Nidhood/PROJECT-CEFIRO/cefiro_gui/THIRD_PARTY_NOTICES.md

The interface architecture and interaction patterns take inspiration from:

- `iKramper/qube-servo-2-in-ros-2/qube_servo2_gui` (2026), original author Elkin Estrada.
- Reference URL: https://github.com/iKramper/qube-servo-2-in-ros-2/tree/main/qube_servo2_gui
- Reference repository MIT license: https://github.com/iKramper/qube-servo-2-in-ros-2/blob/main/LICENSE

CEFIRO implementation consists of new source files customized for the 3-DOF attitude telemetry and controller message contract. Named themes and instrument conventions refer to the original open-source project; this does not establish binary or behavioral equivalence with the original QUBE package.
