Nidhood/PROJECT-CEFIRO/cefiro_description/meshes/frame/prop_ccw.stl

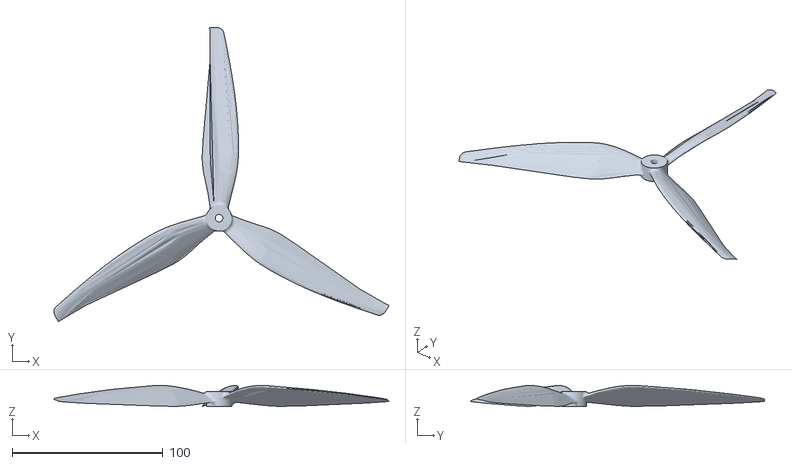
[picture p6: CAD file, 2026-11-02]
cefiro_description/meshes/frame/prop_ccw.stl
222.0 x 195.1 x 14.0
