Nidhood/PROJECT-CEFIRO/cefiro_description/meshes/gyro/narya_ring.stl

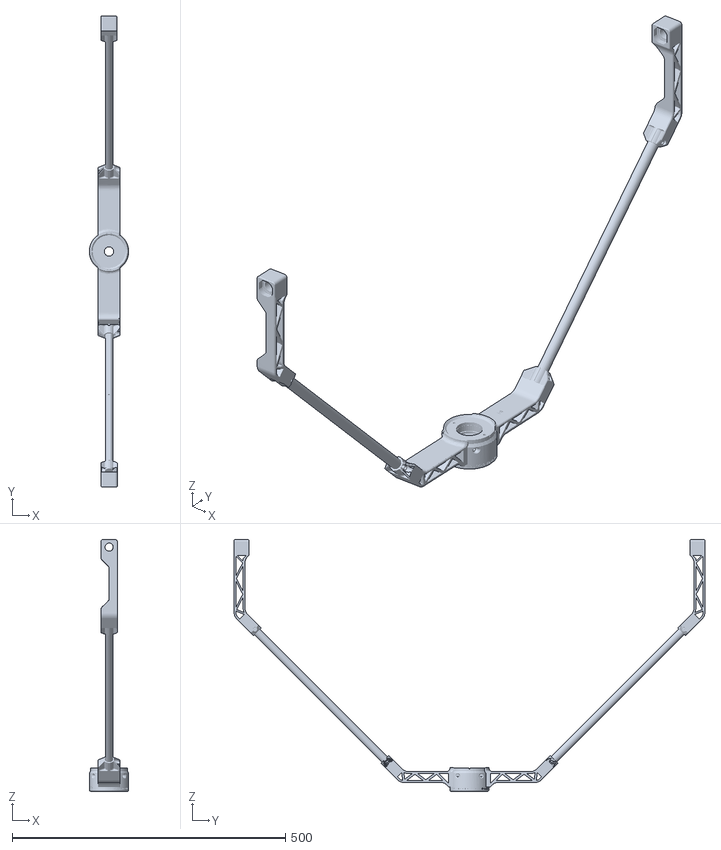
[picture p7: CAD file, 2026-11-02]
cefiro_description/meshes/gyro/narya_ring.stl
72.0 x 861.6 x 461.3
