Nidhood/PROJECT-CEFIRO/cefiro_description/meshes/motor_d3536_1.stl

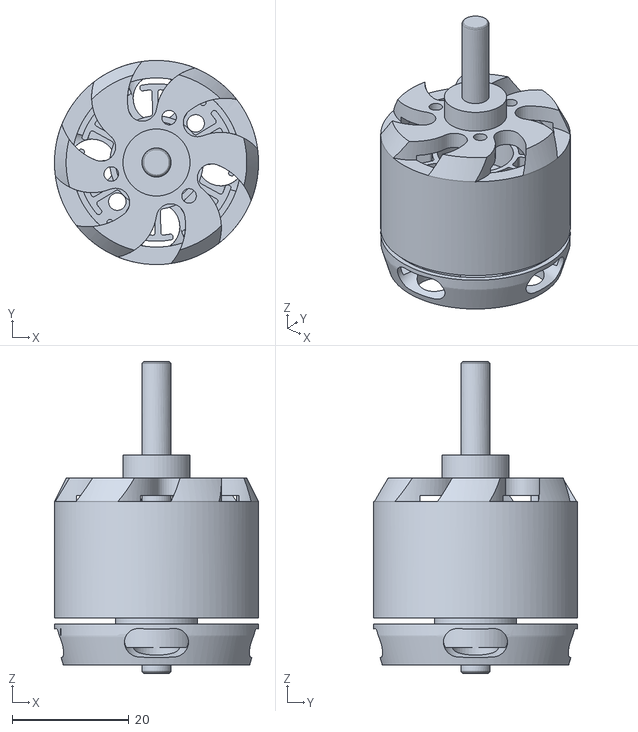
[picture p8: CAD file, 2026-10-26]
cefiro_description/meshes/motor_d3536_1.stl
35.0 x 35.0 x 53.5
