Nidhood/PROJECT-CEFIRO/cefiro_gz/models/desk/meshes/stl/Part__Feature131.stl

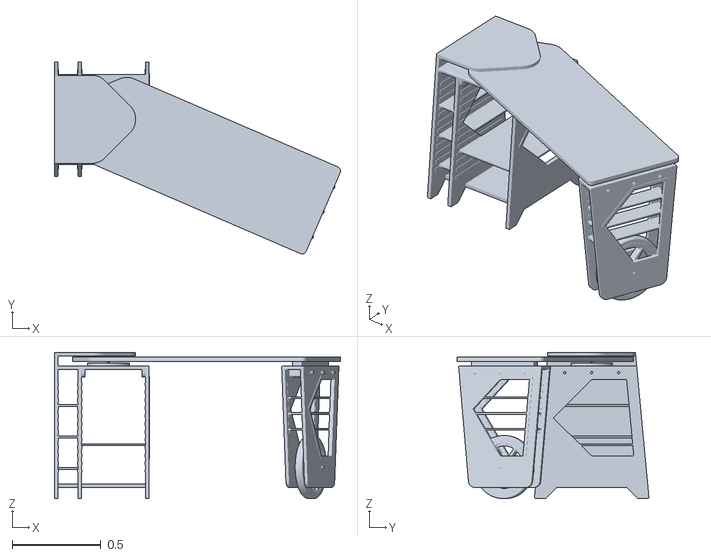
[picture p9: CAD file, 2026-09-05]
cefiro_gz/models/desk/meshes/stl/Part__Feature131.stl
1.62 x 1.08 x 0.825
