Nidhood/PROJECT-CEFIRO/cefiro_gz/models/lamp/meshes/stl/Malla.046.stl

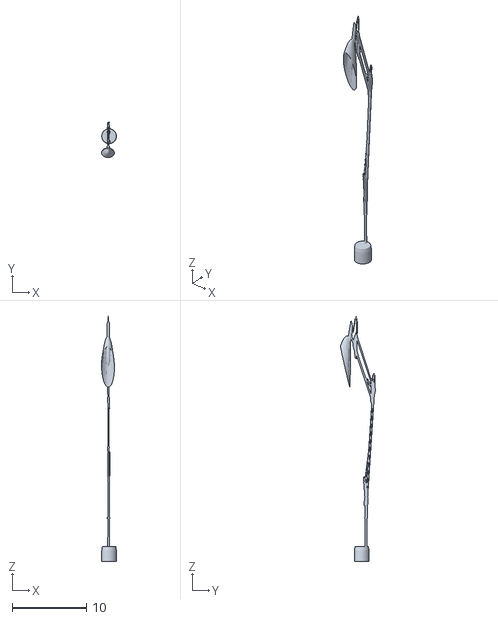
[picture p10: CAD file, 2026-09-05]
cefiro_gz/models/lamp/meshes/stl/Malla.046.stl
2.01 x 4.72 x 33.0
