Nidhood/PROJECT-CEFIRO/cefiro_sensors/urdf/bmp581/meshes/visuals/base_link.stl

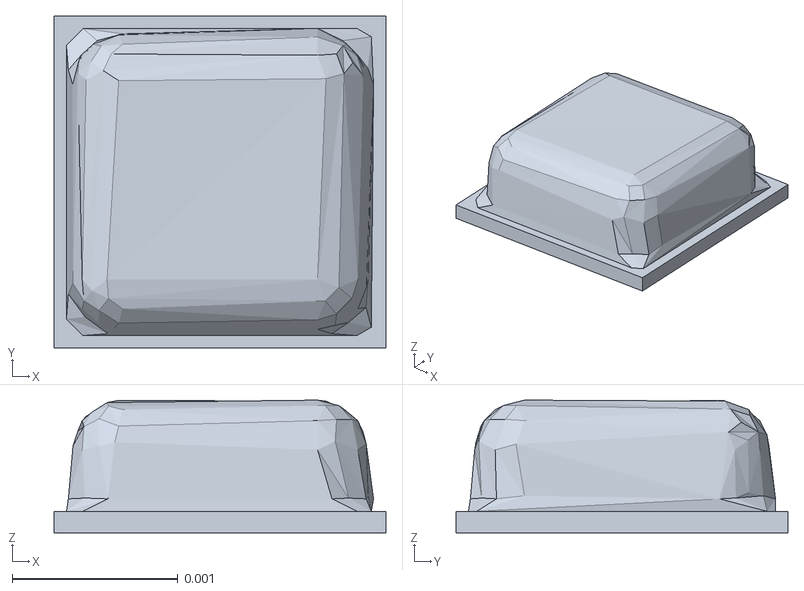
[picture p11: CAD file, 2026-09-05]
cefiro_sensors/urdf/bmp581/meshes/visuals/base_link.stl
0.002 x 0.002 x 0.0008
