Nidhood/PROJECT-CEFIRO/cefiro_sensors/urdf/imu_icm42670p/meshes/base_link.stl

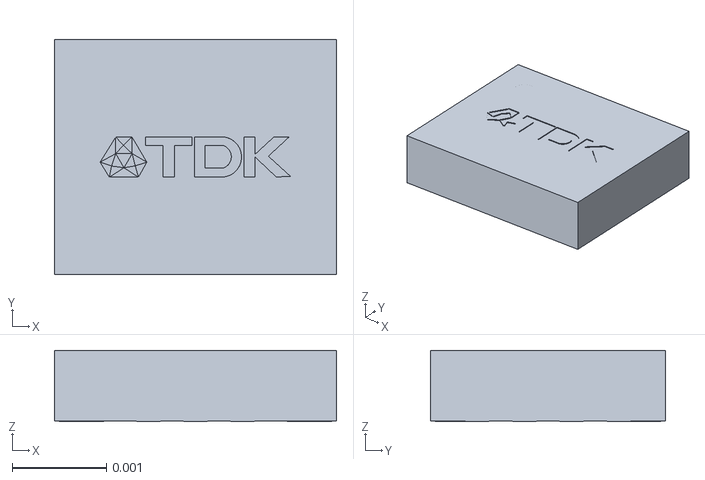
[picture p12: CAD file, 2026-09-12]
cefiro_sensors/urdf/imu_icm42670p/meshes/base_link.stl
0.003 x 0.0025 x 0.00076
