Nidhood/PROJECT-CEFIRO/cefiro_sensors/urdf/magnetometer_mmc5983ma/meshes/base_link.stl

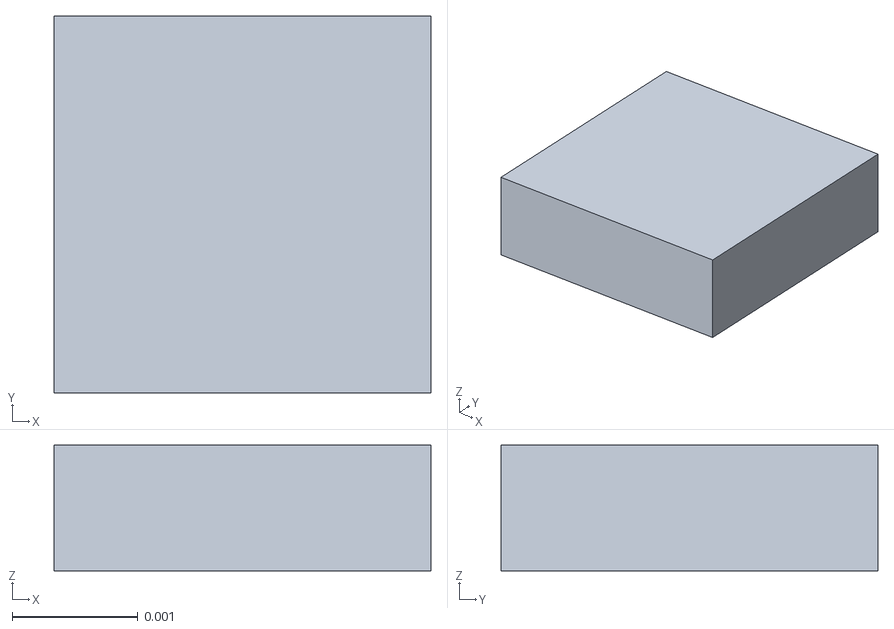
[picture p13: CAD file, 2026-09-12]
cefiro_sensors/urdf/magnetometer_mmc5983ma/meshes/base_link.stl
0.003 x 0.003 x 0.001
