Nidhood/PROJECT-CEFIRO/cefiro_description/meshes/fmu_dummy_1.stl

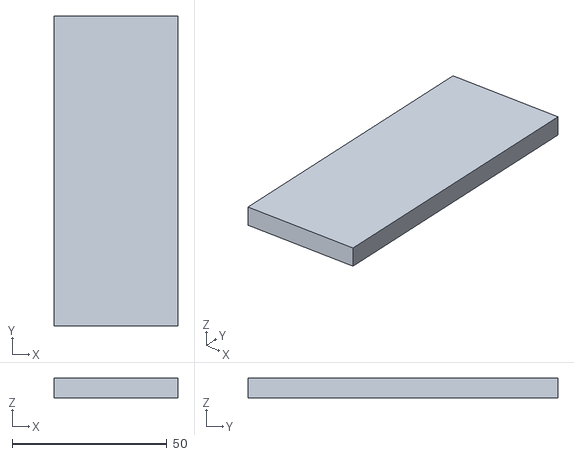
[picture p14: CAD file, 2026-10-26]
cefiro_description/meshes/fmu_dummy_1.stl
40.0 x 100.0 x 6.30
