Nidhood/PROJECT-CEFIRO/cefiro_description/meshes/frame/frame.stl

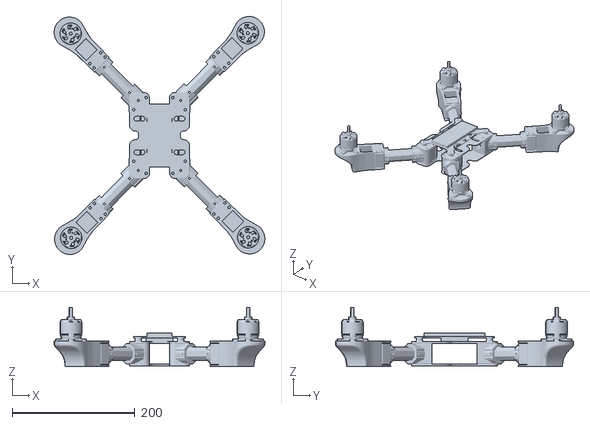
[picture p15: CAD file, 2026-11-02]
cefiro_description/meshes/frame/frame.stl
343.7 x 388.1 x 97.0
