Nidhood/PROJECT-CEFIRO/cefiro_description/meshes/gyro/base.stl

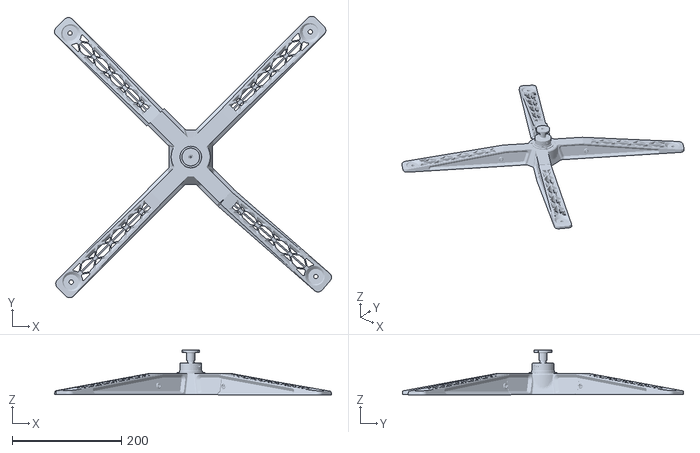
[picture p16: CAD file, 2026-11-02]
cefiro_description/meshes/gyro/base.stl
508.2 x 516.2 x 82.0
