Nidhood/PROJECT-CEFIRO/cefiro_description/meshes/gyro/vilya_ring.stl

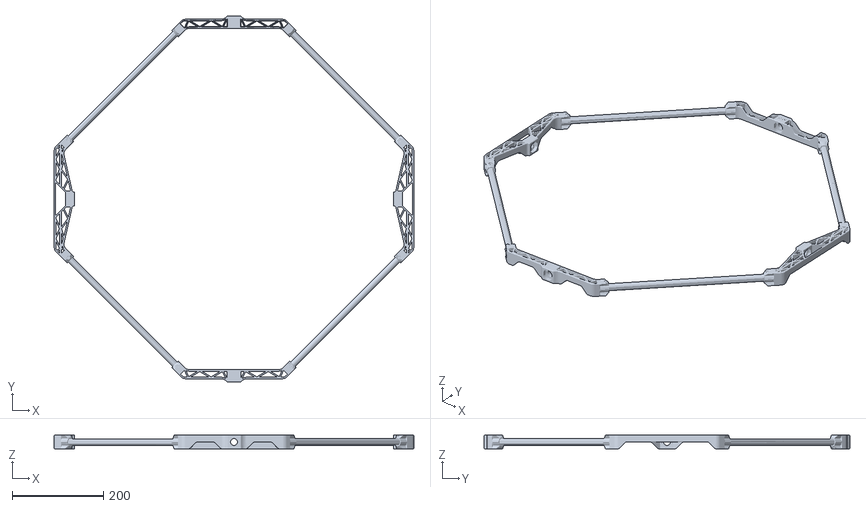
[picture p17: CAD file, 2026-11-02]
cefiro_description/meshes/gyro/vilya_ring.stl
787.8 x 801.8 x 30.0
