Nidhood/PROJECT-CEFIRO/cefiro_description/meshes/propeller_arm__1__1.stl

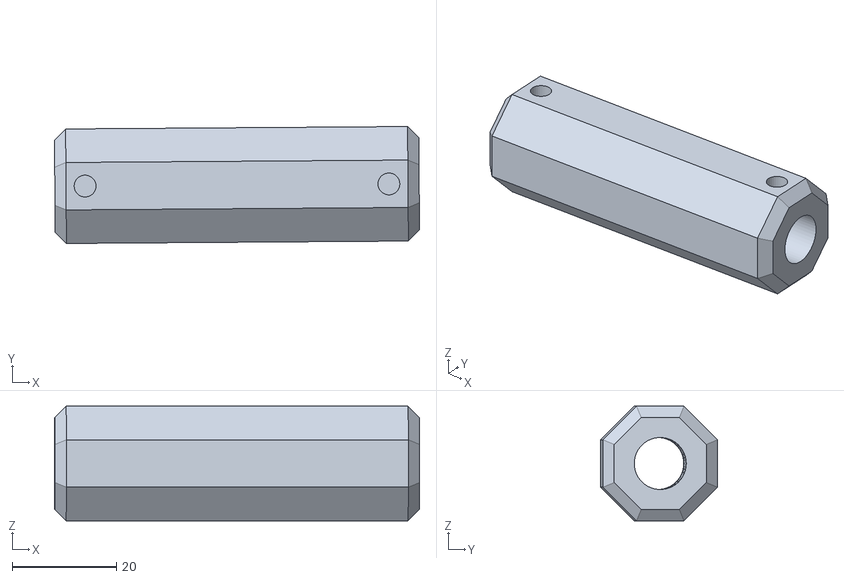
[picture p18: CAD file, 2026-10-26]
cefiro_description/meshes/propeller_arm__1__1.stl
70.1 x 22.5 x 22.0
