Nidhood/PROJECT-CEFIRO/cefiro_description/meshes/frame/motor_coupling__2__1.stl

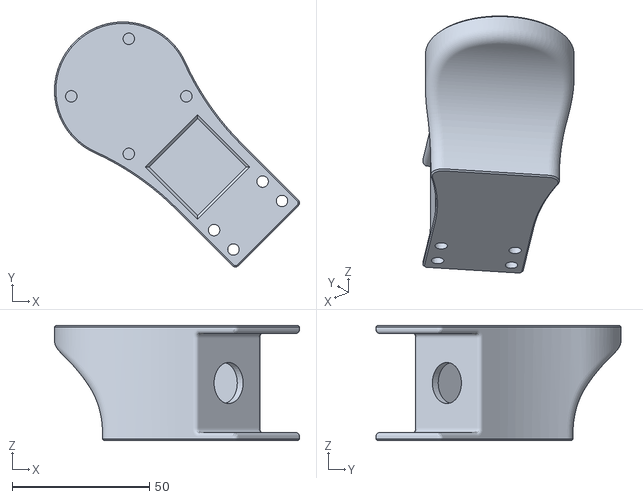
[picture p19: CAD file, 2026-10-28]
cefiro_description/meshes/frame/motor_coupling__2__1.stl
89.4 x 89.4 x 42.0
