Nidhood/PROJECT-CEFIRO/cefiro_description/meshes/gyro/nenya_ring.stl

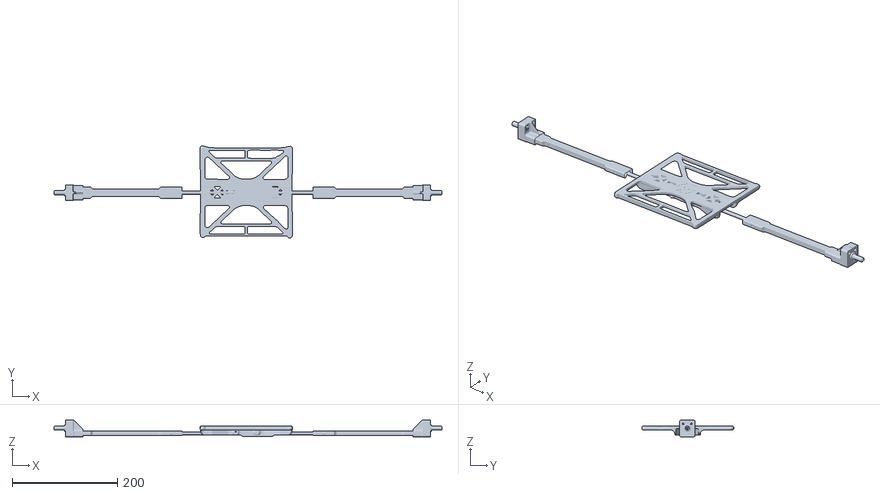
[picture p20: CAD file, 2026-11-02]
cefiro_description/meshes/gyro/nenya_ring.stl
737.8 x 175.4 x 31.5
