Nidhood/PROJECT-CEFIRO/cefiro_description/meshes/gyro_CF_Rod_1.stl

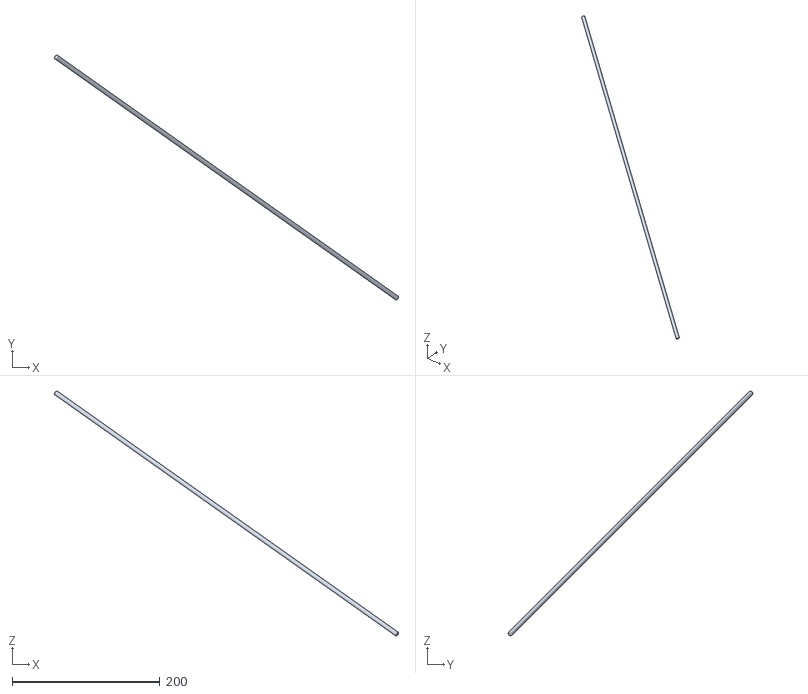
[picture p21: CAD file, 2026-10-26]
cefiro_description/meshes/gyro_CF_Rod_1.stl
465.3 x 331.2 x 331.2
