Nidhood/PROJECT-CEFIRO/cefiro_description/meshes/frame/damper_plate__1.stl

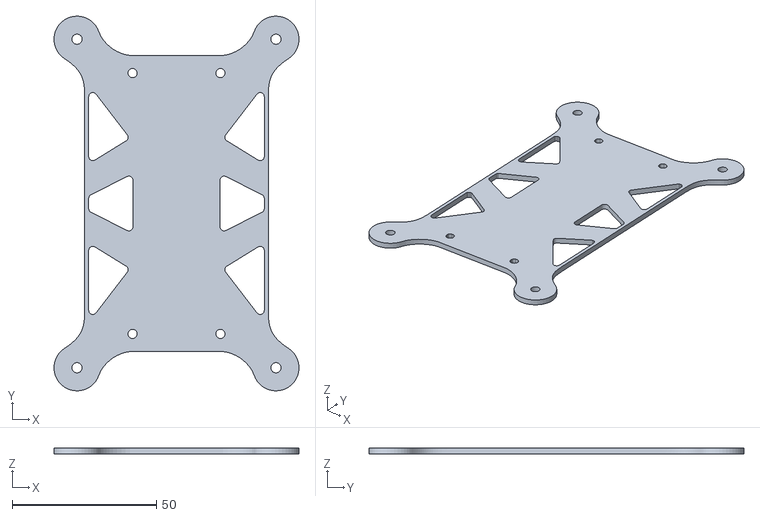
[picture p22: CAD file, 2026-10-28]
cefiro_description/meshes/frame/damper_plate__1.stl
85.0 x 130.0 x 2.10
