Nidhood/PROJECT-CEFIRO/cefiro_description/meshes/gyro/gyro_snap-in-leg__1__1.stl

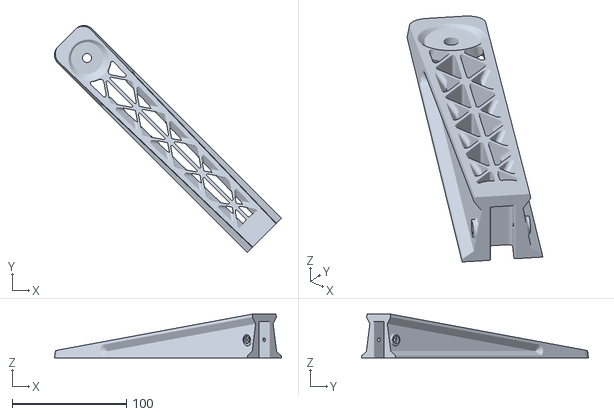
[picture p23: CAD file, 2026-10-28]
cefiro_description/meshes/gyro/gyro_snap-in-leg__1__1.stl
199.0 x 199.0 x 38.5
