Nidhood/PROJECT-CEFIRO/cefiro_description/meshes/gyro_A1-LW_1.stl

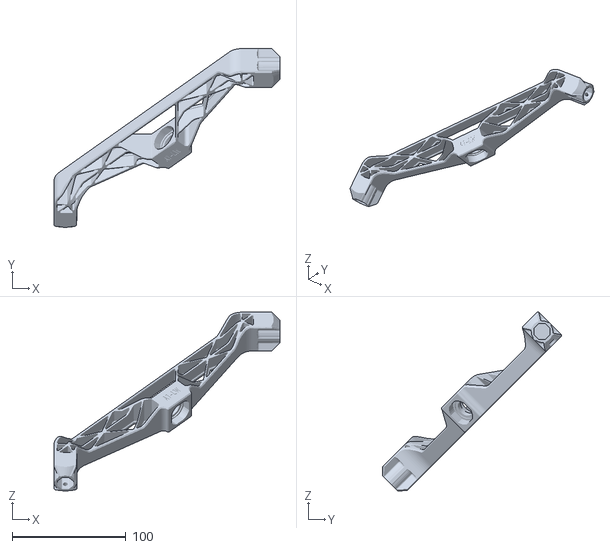
[picture p24: CAD file, 2026-10-26]
cefiro_description/meshes/gyro_A1-LW_1.stl
198.5 x 157.0 x 157.2
