Nidhood/PROJECT-CEFIRO/cefiro_description/meshes/damper_rubber__2__1.stl

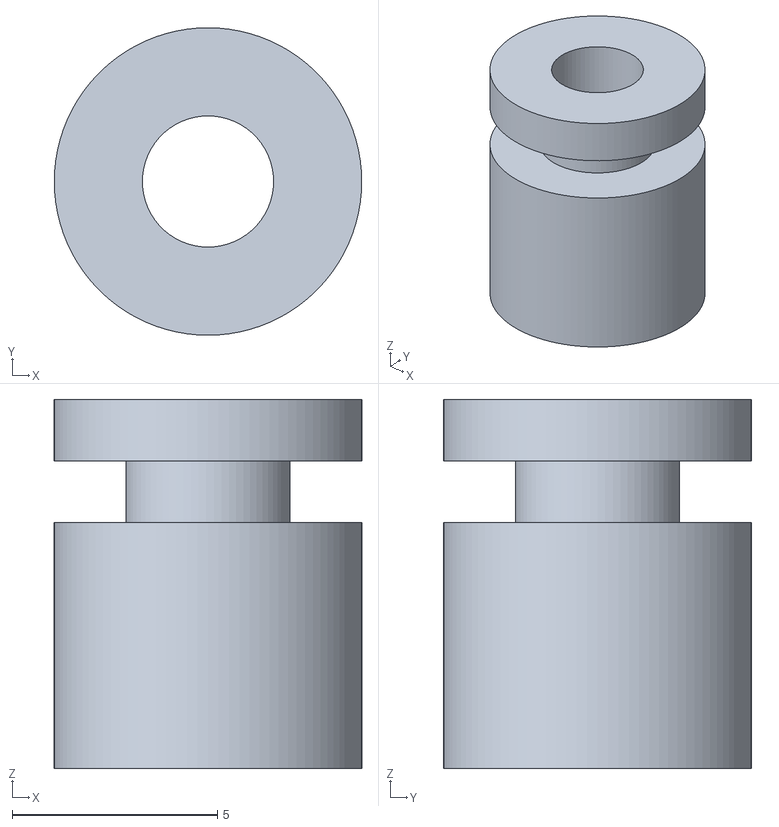
[picture p25: CAD file, 2026-10-26]
cefiro_description/meshes/damper_rubber__2__1.stl
7.50 x 7.50 x 9.00
