Nidhood/PROJECT-CEFIRO/cefiro_description/meshes/gyro/gyro_B2S-R_1.stl

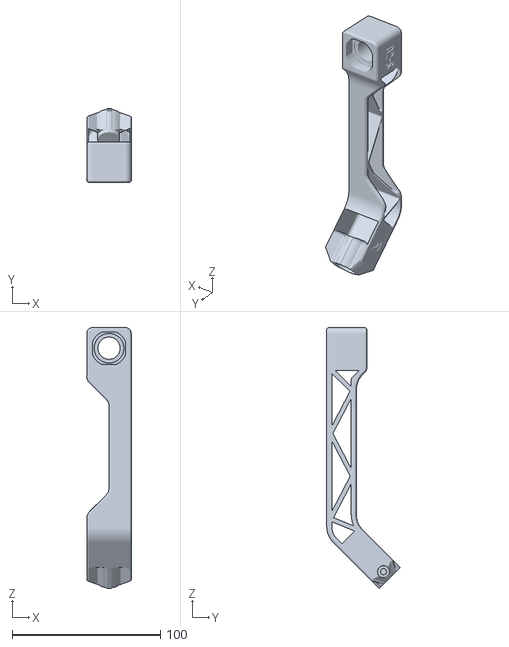
[picture p26: CAD file, 2026-10-28]
cefiro_description/meshes/gyro/gyro_B2S-R_1.stl
30.1 x 49.6 x 175.9
