Nidhood/PROJECT-CEFIRO/cefiro_description/meshes/frame/propeller_arm__2__1.stl

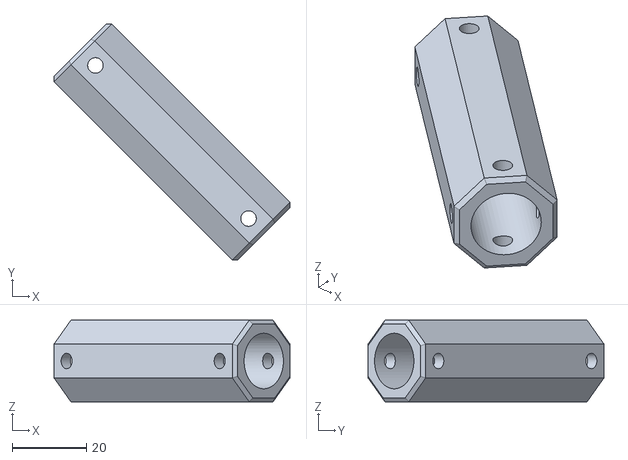
[picture p27: CAD file, 2026-10-28]
cefiro_description/meshes/frame/propeller_arm__2__1.stl
63.6 x 63.6 x 22.0
