Nidhood/PROJECT-CEFIRO/cefiro_description/meshes/gyro_drone_baseB_1.stl

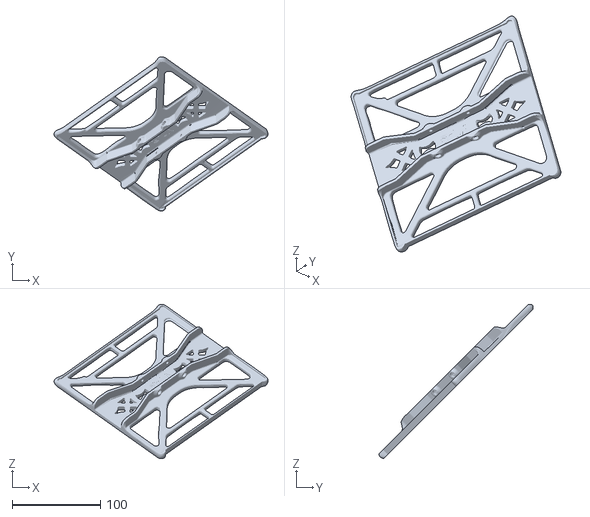
[picture p28: CAD file, 2026-10-26]
cefiro_description/meshes/gyro_drone_baseB_1.stl
243.1 x 175.2 x 175.4
