Nidhood/PROJECT-CEFIRO/cefiro_description/meshes/frame/motor_d3536_mount__2__1.stl

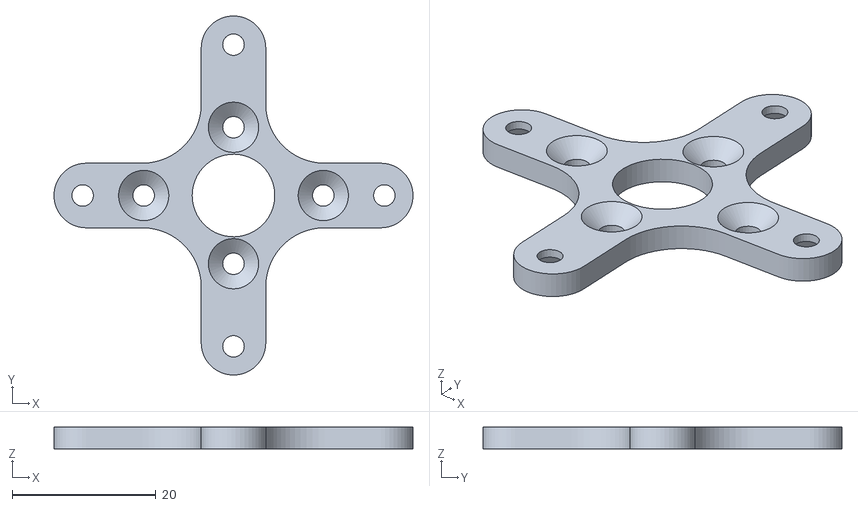
[picture p29: CAD file, 2026-10-28]
cefiro_description/meshes/frame/motor_d3536_mount__2__1.stl
50.0 x 50.0 x 3.00
