Nidhood/PROJECT-CEFIRO/cefiro_description/meshes/gyro/gyro_X1__1__1.stl

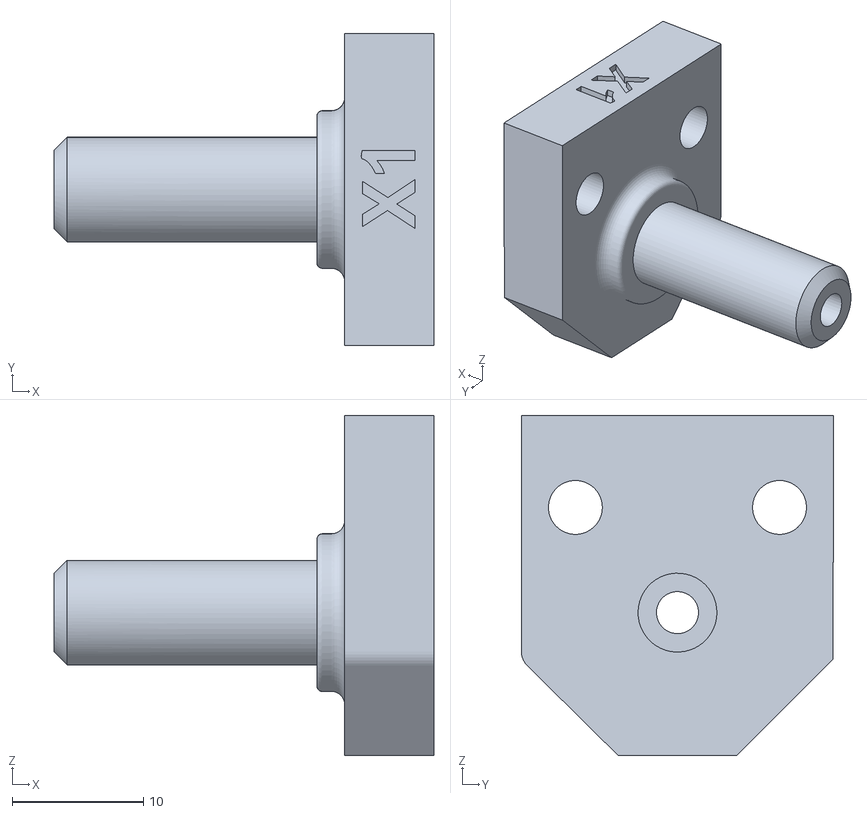
[picture p30: CAD file, 2026-10-28]
cefiro_description/meshes/gyro/gyro_X1__1__1.stl
28.9 x 23.8 x 25.9
