Nidhood/PROJECT-CEFIRO/cefiro_description/meshes/frame/arm_coupling_left__1.stl

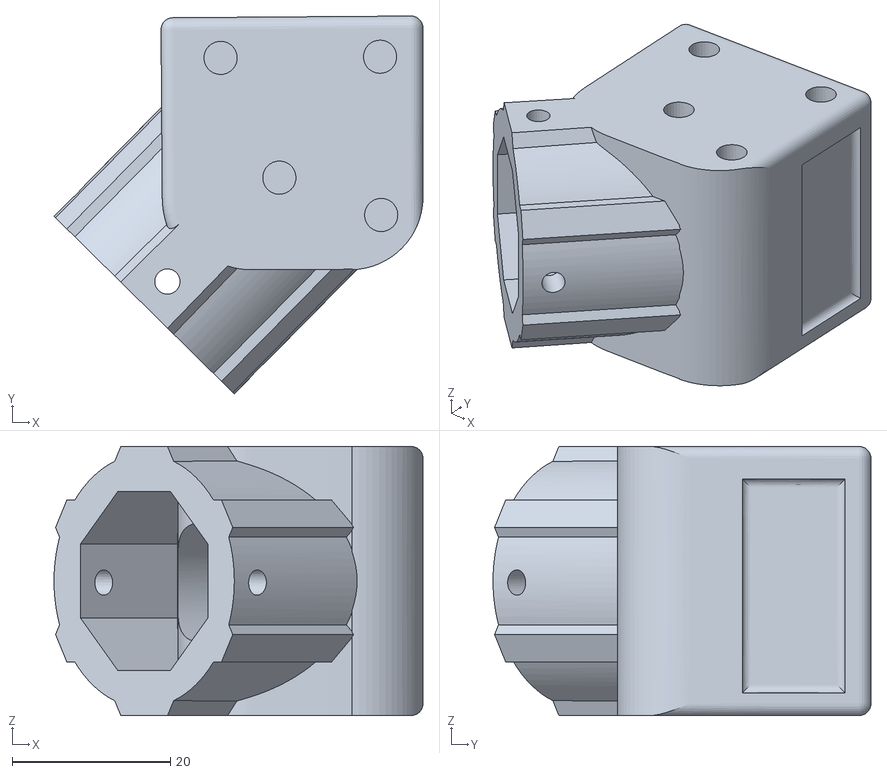
[picture p31: CAD file, 2026-10-28]
cefiro_description/meshes/frame/arm_coupling_left__1.stl
46.6 x 47.8 x 34.0
