Nidhood/PROJECT-CEFIRO/cefiro_description/meshes/gyro/gyro_A2-LW_1.stl

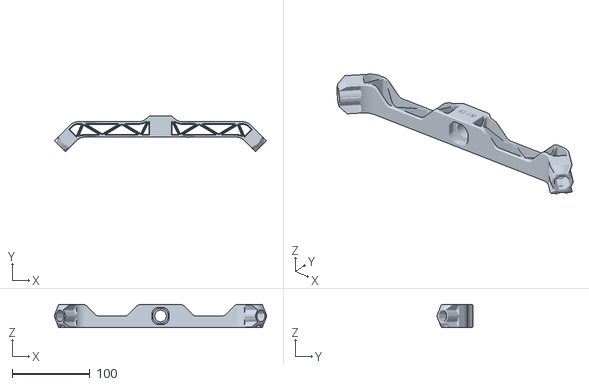
[picture p32: CAD file, 2026-10-28]
cefiro_description/meshes/gyro/gyro_A2-LW_1.stl
273.4 x 46.0 x 30.0
