Nidhood/PROJECT-CEFIRO/cefiro_description/meshes/gyro_A2-LW_1.stl

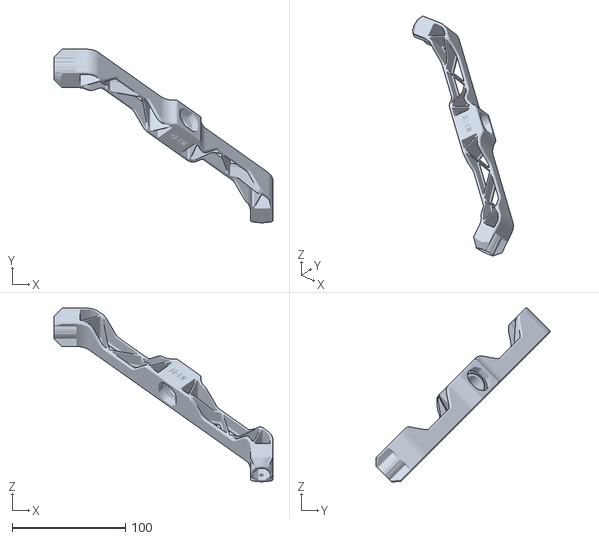
[picture p33: CAD file, 2026-10-26]
cefiro_description/meshes/gyro_A2-LW_1.stl
193.3 x 153.3 x 153.3
