Nidhood/PROJECT-CEFIRO/cefiro_description/meshes/gyro/gyro_CON-P_360mm__2__1.stl

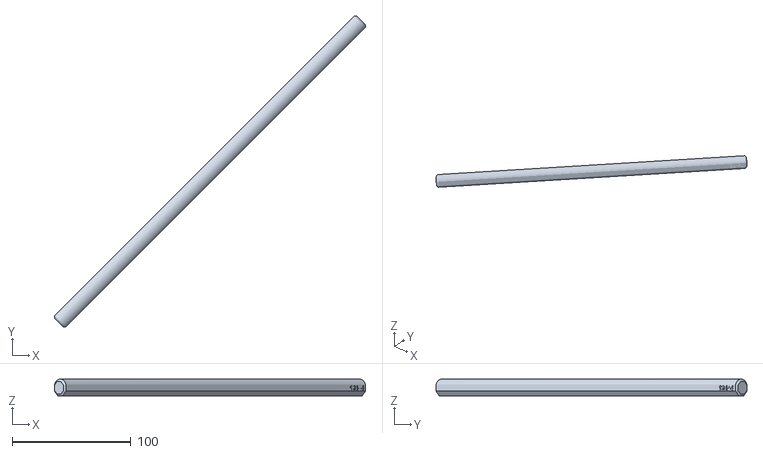
[picture p34: CAD file, 2026-10-28]
cefiro_description/meshes/gyro/gyro_CON-P_360mm__2__1.stl
262.2 x 262.2 x 14.2
