Nidhood/PROJECT-CEFIRO/cefiro_description/meshes/arm-motor_coupling__2__1.stl

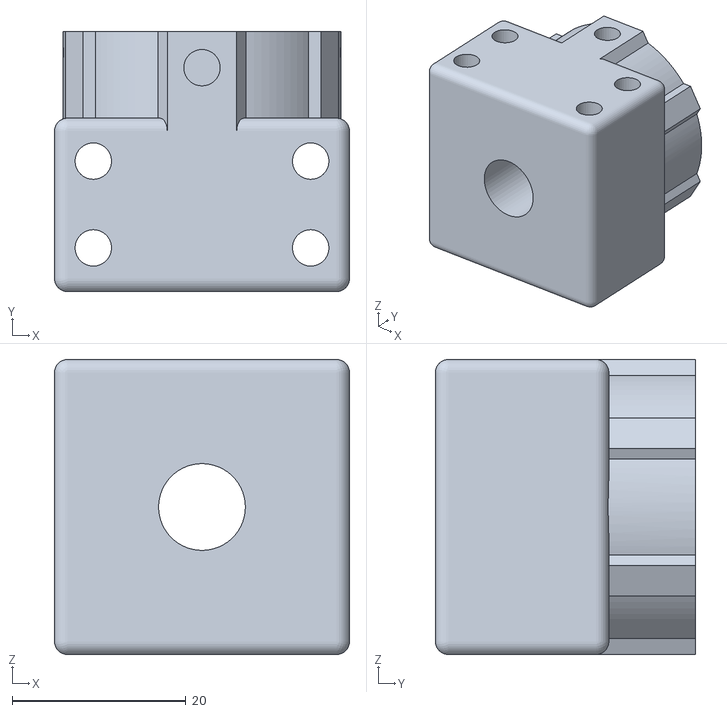
[picture p35: CAD file, 2026-10-26]
cefiro_description/meshes/arm-motor_coupling__2__1.stl
34.0 x 30.0 x 34.0
