Nidhood/PROJECT-CEFIRO/cefiro_description/meshes/gyro/gyro_R-BED__1__1.stl

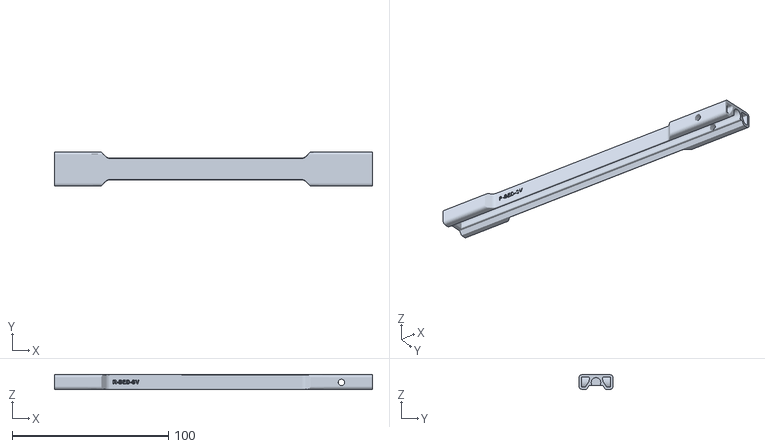
[picture p36: CAD file, 2026-10-28]
cefiro_description/meshes/gyro/gyro_R-BED__1__1.stl
203.6 x 21.9 x 9.40
