Nidhood/PROJECT-CEFIRO/cefiro_description/meshes/base_link.stl

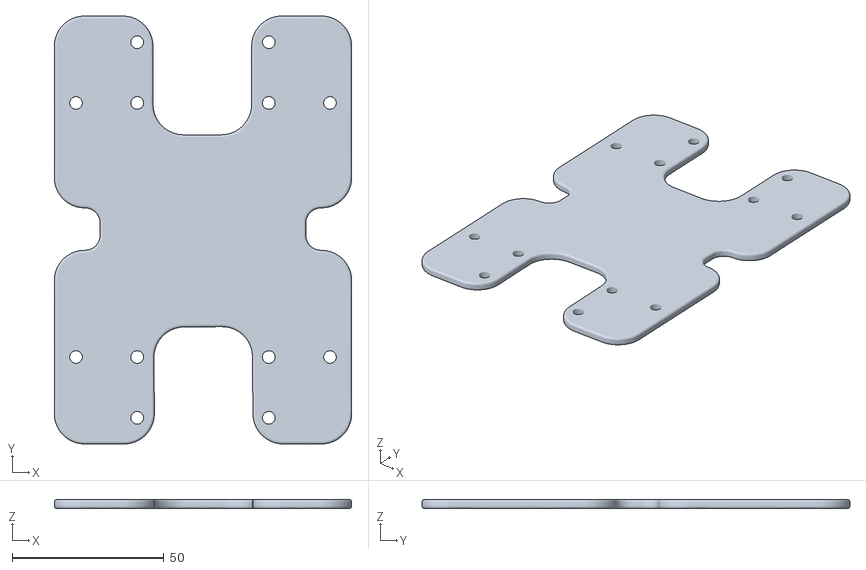
[picture p37: CAD file, 2026-10-26]
cefiro_description/meshes/base_link.stl
98.0 x 141.0 x 3.00
