Nidhood/PROJECT-CEFIRO/cefiro_description/meshes/gyro/gyro_CON-Y_368mm__1__1.stl

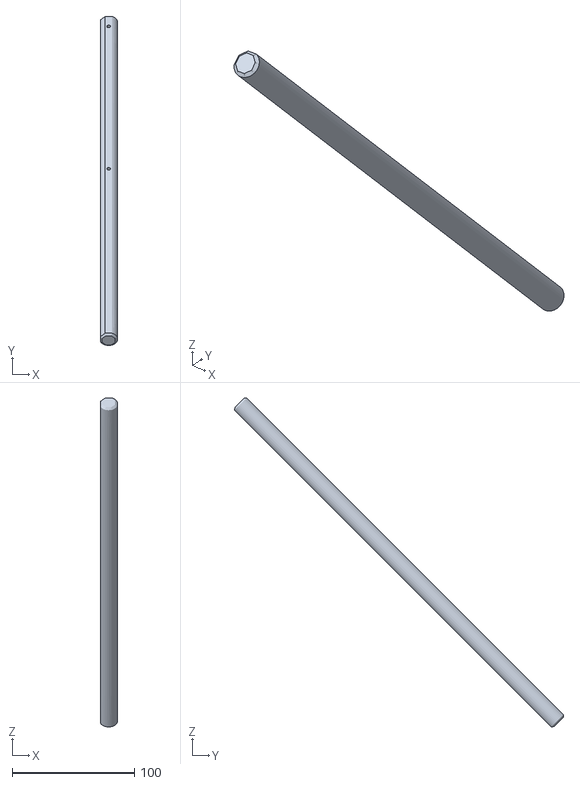
[picture p38: CAD file, 2026-10-28]
cefiro_description/meshes/gyro/gyro_CON-Y_368mm__1__1.stl
14.2 x 269.6 x 269.6
