Nidhood/PROJECT-CEFIRO/cefiro_description/meshes/arm_coupling_1.stl

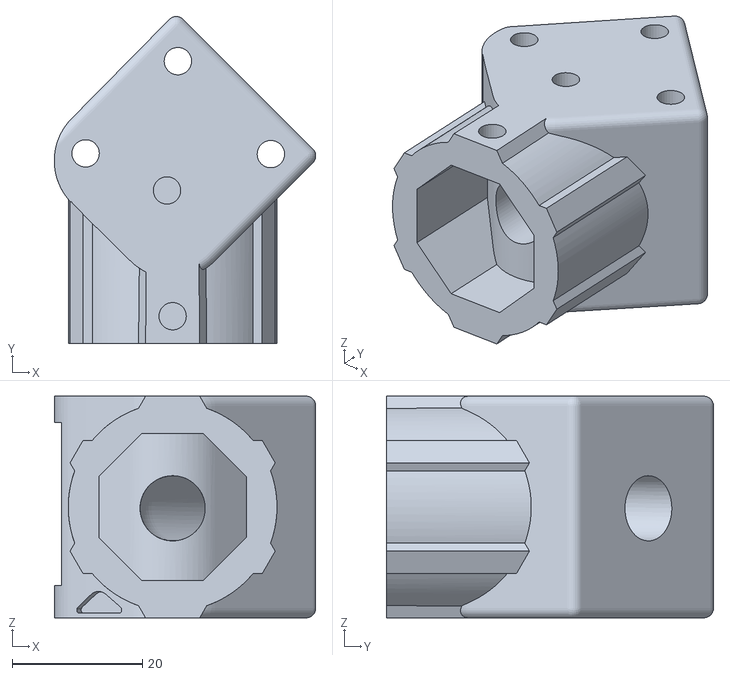
[picture p39: CAD file, 2026-10-26]
cefiro_description/meshes/arm_coupling_1.stl
40.1 x 50.1 x 34.0
