Nidhood/PROJECT-CEFIRO/cefiro_description/meshes/gyro/gyro_base_CPv12_1.stl

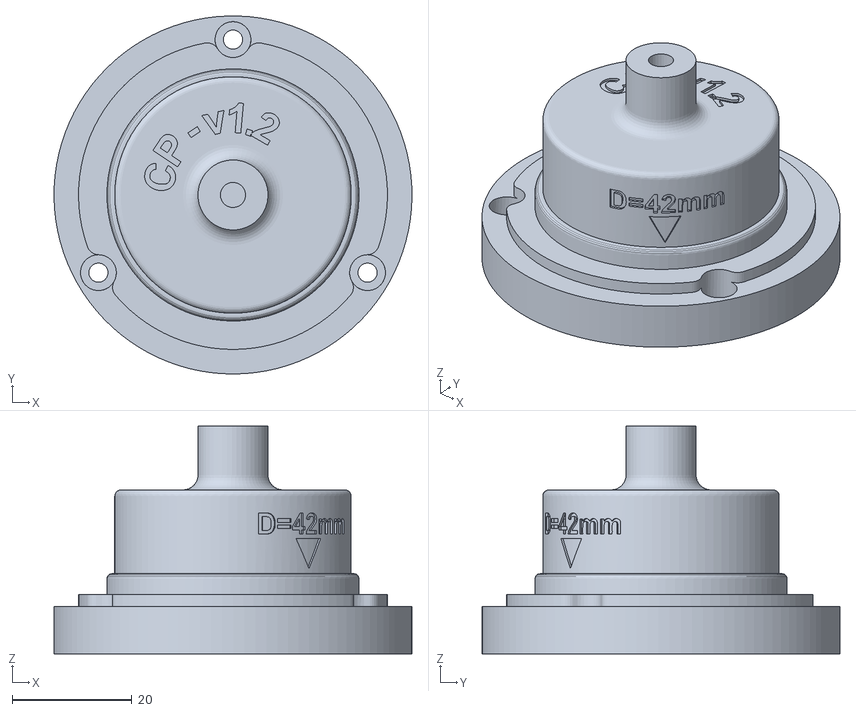
[picture p40: CAD file, 2026-10-28]
cefiro_description/meshes/gyro/gyro_base_CPv12_1.stl
59.8 x 59.8 x 38.1
