Nidhood/PROJECT-CEFIRO/cefiro_description/meshes/frame/chassis_upper_plate_1.stl

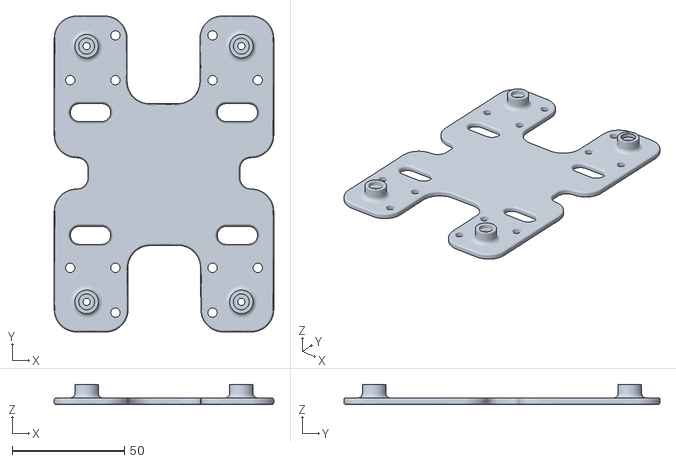
[picture p41: CAD file, 2026-10-28]
cefiro_description/meshes/frame/chassis_upper_plate_1.stl
98.0 x 141.0 x 9.00
