Nidhood/PROJECT-CEFIRO/cefiro_description/meshes/gyro/gyro_X1-SV_1.stl

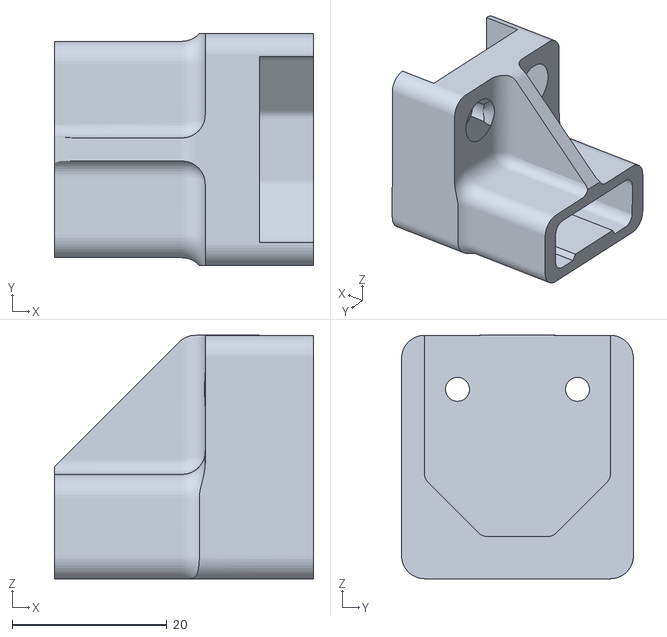
[picture p42: CAD file, 2026-10-28]
cefiro_description/meshes/gyro/gyro_X1-SV_1.stl
33.5 x 30.0 x 31.5
