Nidhood/PROJECT-CEFIRO/cefiro_description/meshes/frame/motor_coupling__1__1.stl

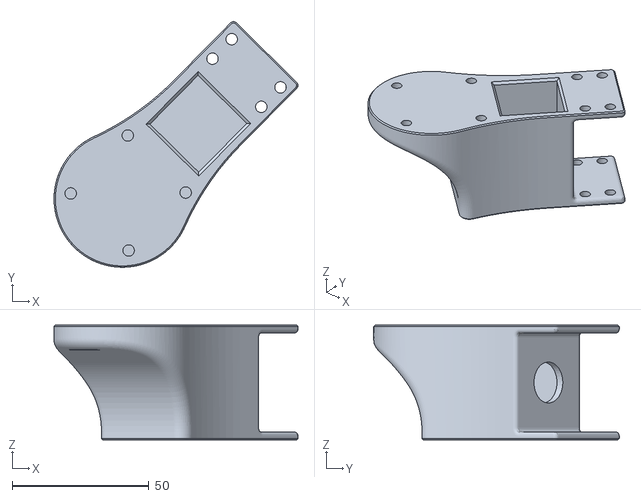
[picture p43: CAD file, 2026-10-28]
cefiro_description/meshes/frame/motor_coupling__1__1.stl
89.1 x 89.7 x 42.0
