Nidhood/PROJECT-CEFIRO/cefiro_description/meshes/frame/arm-motor_coupling__2__1.stl

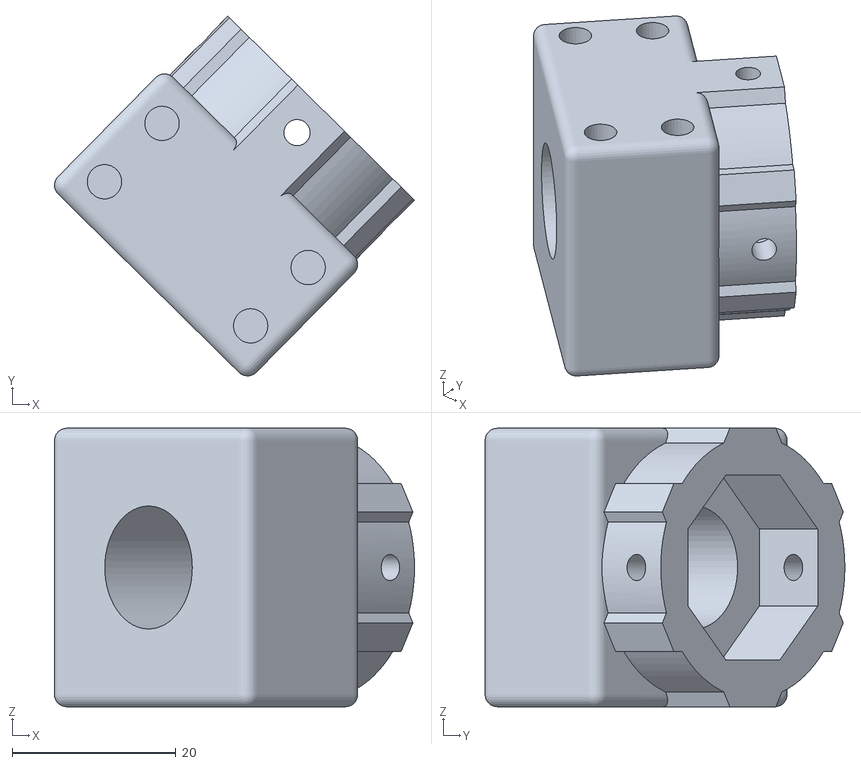
[picture p44: CAD file, 2026-10-28]
cefiro_description/meshes/frame/arm-motor_coupling__2__1.stl
43.9 x 43.9 x 34.0
