Nidhood/PROJECT-CEFIRO/cefiro_description/meshes/gyro/base_link.stl

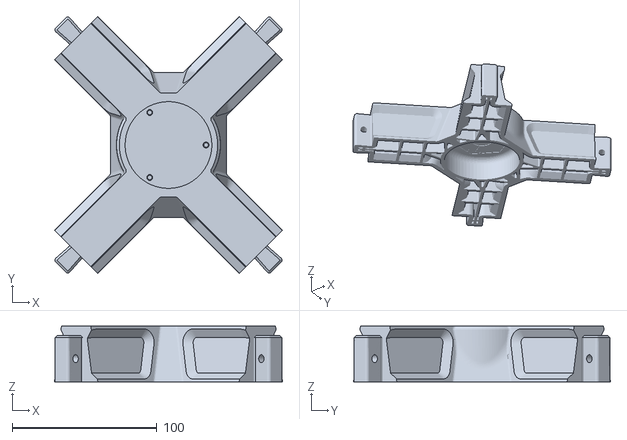
[picture p45: CAD file, 2026-10-28]
cefiro_description/meshes/gyro/base_link.stl
157.8 x 177.8 x 38.5
