Nidhood/PROJECT-CEFIRO/cefiro_description/meshes/gyro_R-BED__1__1.stl

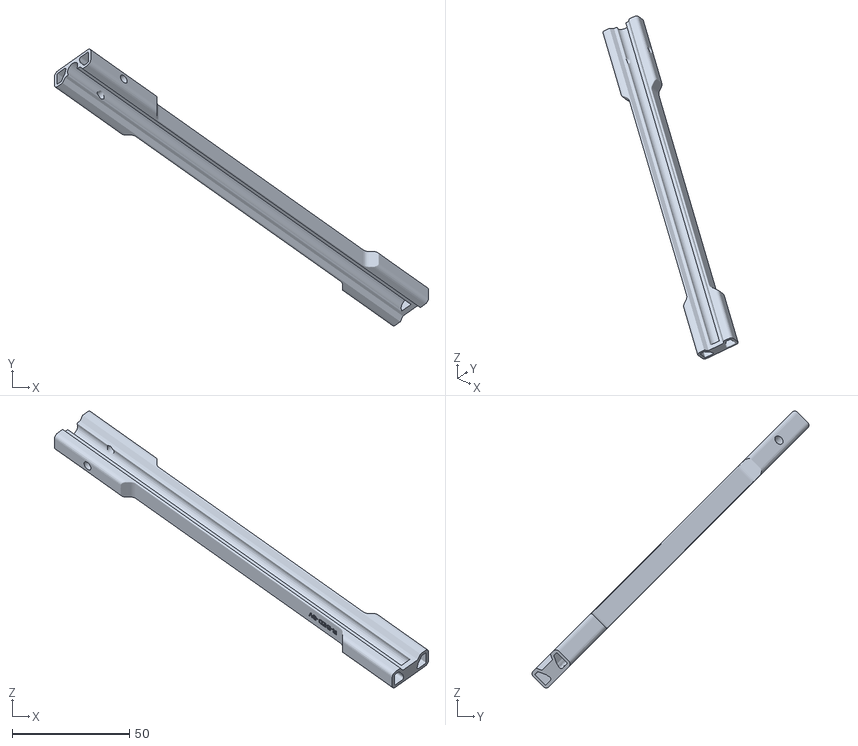
[picture p46: CAD file, 2026-10-26]
cefiro_description/meshes/gyro_R-BED__1__1.stl
159.4 x 118.0 x 118.0
