Nidhood/PROJECT-CEFIRO/cefiro_description/meshes/gyro/gyro_drone_baseB_1.stl

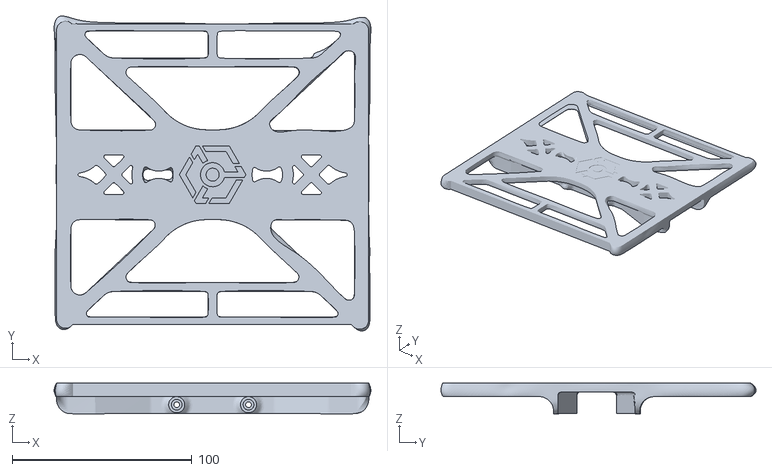
[picture p47: CAD file, 2026-10-28]
cefiro_description/meshes/gyro/gyro_drone_baseB_1.stl
176.4 x 175.4 x 17.1
