Nidhood/PROJECT-CEFIRO/cefiro_description/meshes/gyro_B2S-R_1.stl

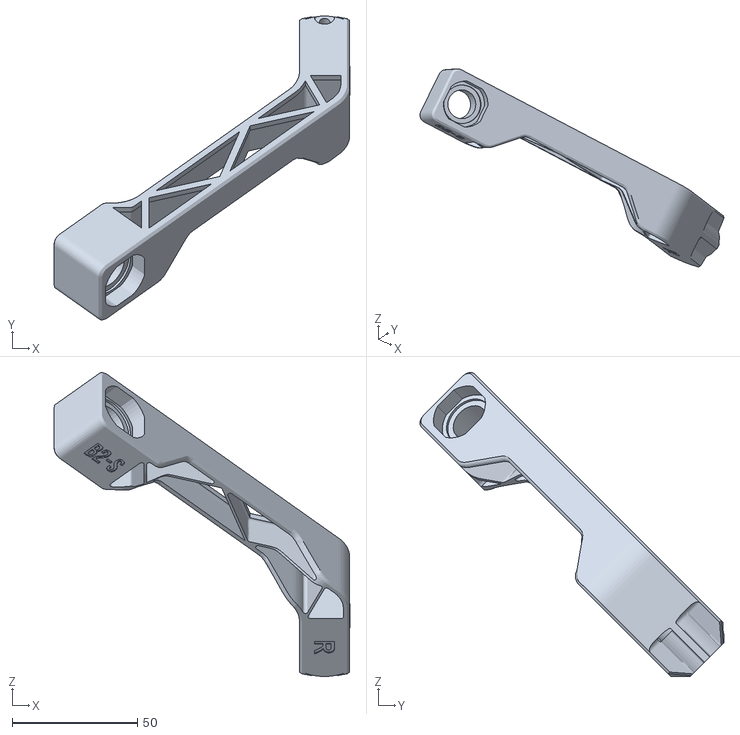
[picture p48: CAD file, 2026-10-26]
cefiro_description/meshes/gyro_B2S-R_1.stl
117.8 x 121.1 x 121.1
