Nidhood/PROJECT-CEFIRO/cefiro_description/meshes/frame/propeller__3__1.stl

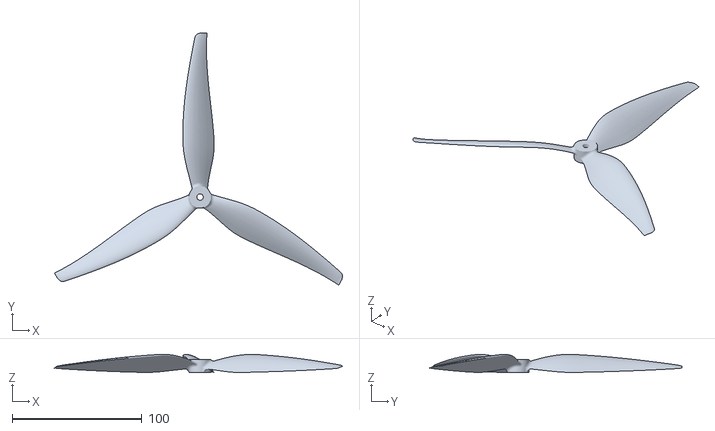
[picture p49: CAD file, 2026-10-28]
cefiro_description/meshes/frame/propeller__3__1.stl
222.0 x 194.4 x 14.0
