Nidhood/PROJECT-CEFIRO/cefiro_description/meshes/gyro/gyro_A1-LW__1__1.stl

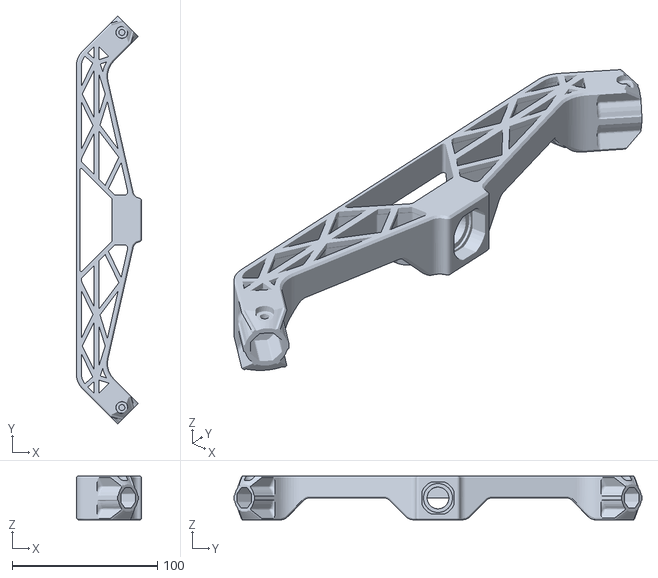
[picture p50: CAD file, 2026-10-28]
cefiro_description/meshes/gyro/gyro_A1-LW__1__1.stl
45.0 x 280.7 x 30.0
