Nidhood/PROJECT-CEFIRO/cefiro_description/meshes/gyro/gyro_Y-DBA_1.stl

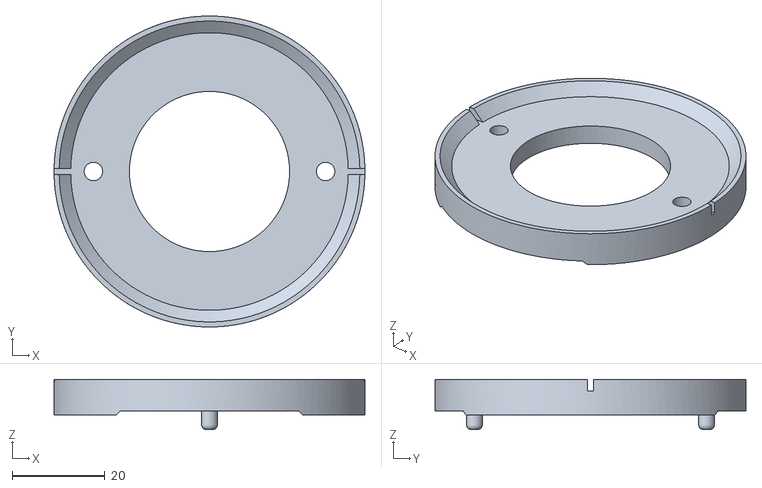
[picture p51: CAD file, 2026-10-28]
cefiro_description/meshes/gyro/gyro_Y-DBA_1.stl
67.0 x 67.0 x 10.8
