Nidhood/PROJECT-CEFIRO/cefiro_description/meshes/gyro/gyro_Y-LOCK_1.stl

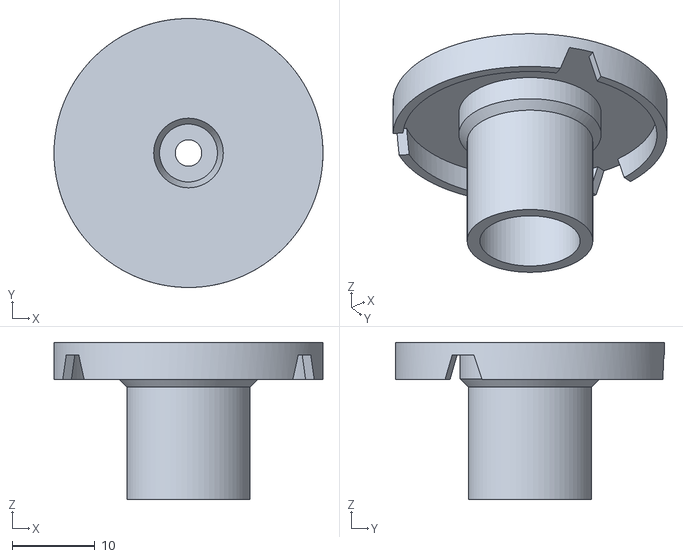
[picture p52: CAD file, 2026-10-28]
cefiro_description/meshes/gyro/gyro_Y-LOCK_1.stl
32.5 x 32.5 x 19.0
