Nidhood/PROJECT-CEFIRO/cefiro_description/meshes/gyro/gyro_B1P_1.stl

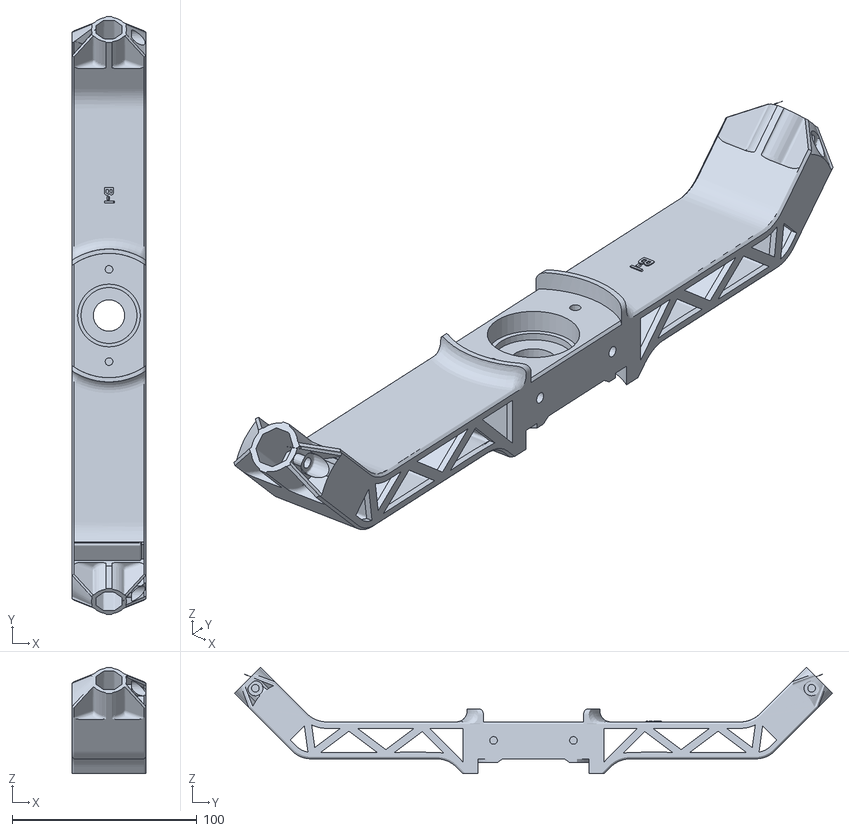
[picture p53: CAD file, 2026-10-28]
cefiro_description/meshes/gyro/gyro_B1P_1.stl
40.0 x 323.9 x 57.6
