Nidhood/PROJECT-CEFIRO/cefiro_description/meshes/gyro/gyro_CF_Rod_1.stl

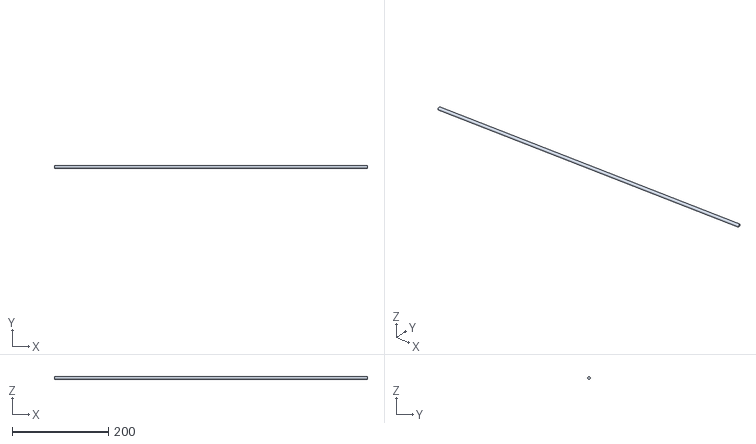
[picture p54: CAD file, 2026-10-28]
cefiro_description/meshes/gyro/gyro_CF_Rod_1.stl
652.0 x 6.00 x 6.00
