Nidhood/PROJECT-CEFIRO/cefiro_description/meshes/gyro_X1-SV_1.stl

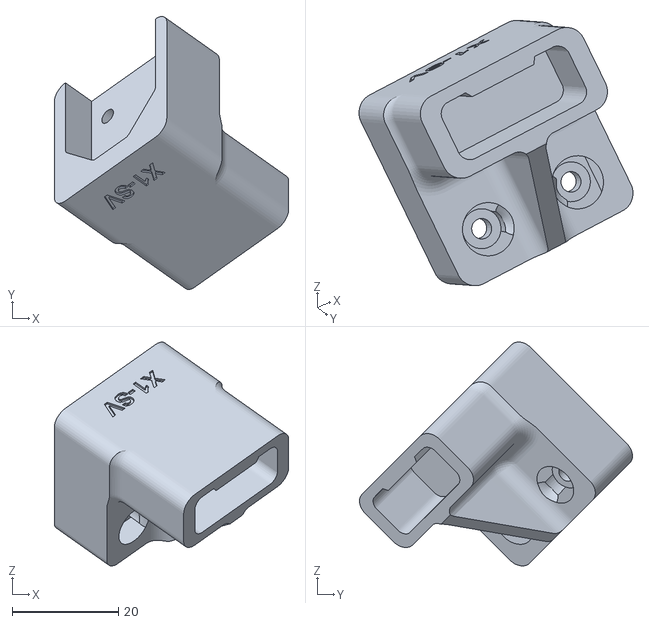
[picture p55: CAD file, 2026-10-26]
cefiro_description/meshes/gyro_X1-SV_1.stl
44.2 x 51.5 x 42.2
