Nidhood/PROJECT-CEFIRO/cefiro_description/meshes/frame/propeller_arm__1__1.stl

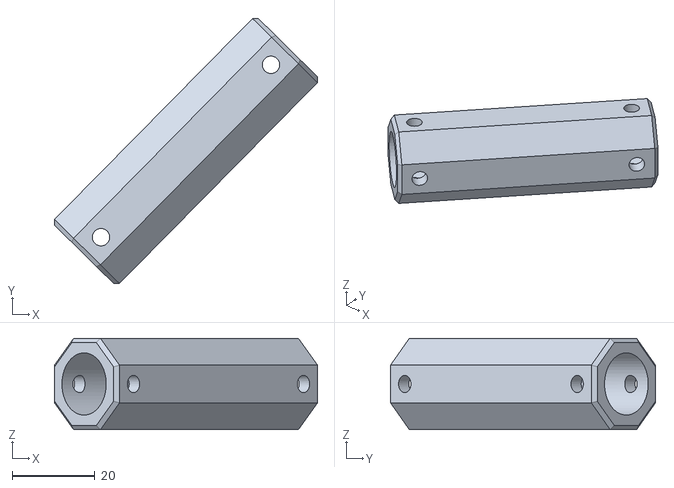
[picture p56: CAD file, 2026-10-28]
cefiro_description/meshes/frame/propeller_arm__1__1.stl
63.4 x 63.9 x 22.0
