Nidhood/PROJECT-CEFIRO/cefiro_description/meshes/gyro/gyro_snap-in-leg__3__1.stl

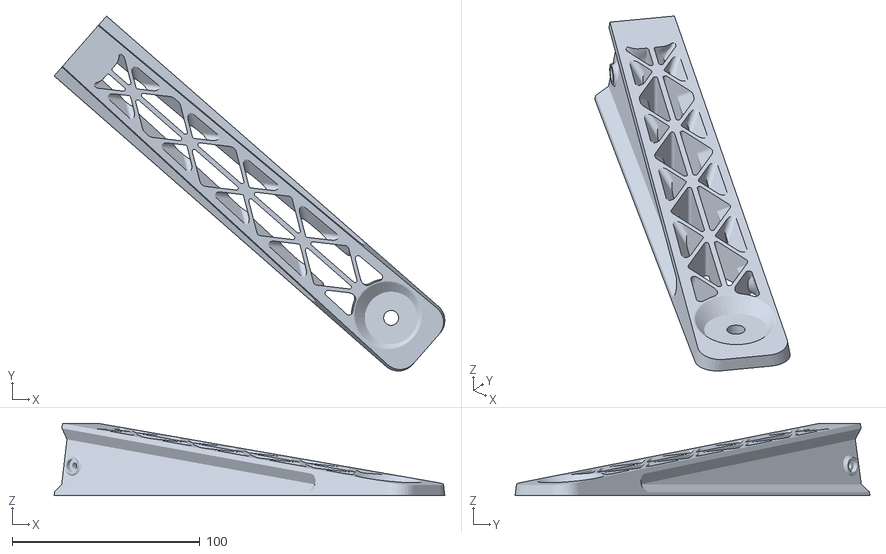
[picture p57: CAD file, 2026-10-28]
cefiro_description/meshes/gyro/gyro_snap-in-leg__3__1.stl
208.1 x 189.1 x 38.5
