Nidhood/PROJECT-CEFIRO/cefiro_description/meshes/gyro/gyro_CON-BED-ADAPTER_6mm_1.stl

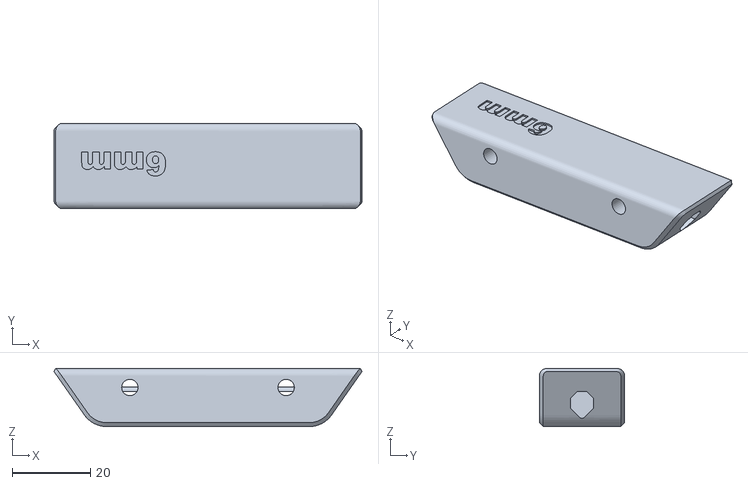
[picture p58: CAD file, 2026-10-28]
cefiro_description/meshes/gyro/gyro_CON-BED-ADAPTER_6mm_1.stl
78.9 x 21.9 x 14.9
