Nidhood/PROJECT-CEFIRO/cefiro_description/meshes/motor_coupling__2__1.stl

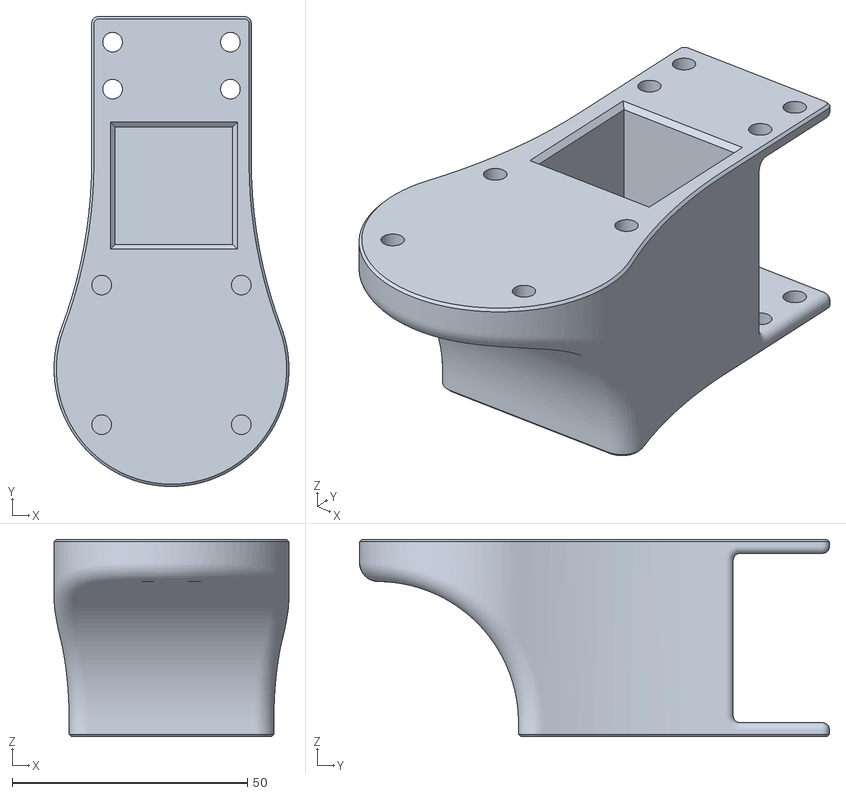
[picture p59: CAD file, 2026-10-26]
cefiro_description/meshes/motor_coupling__2__1.stl
50.0 x 100.0 x 42.0
