Nidhood/PROJECT-CEFIRO/cefiro_description/meshes/frame/esc_dummy_1.stl

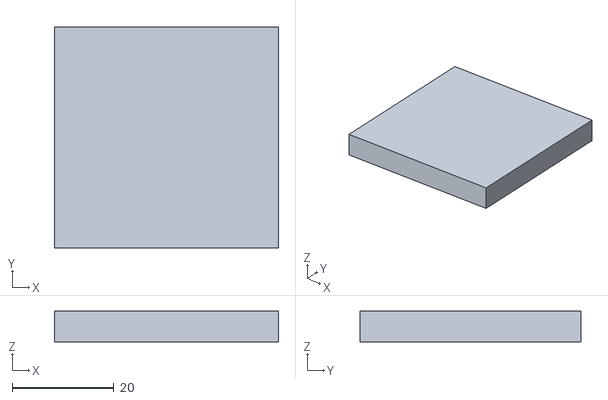
[picture p60: CAD file, 2026-10-28]
cefiro_description/meshes/frame/esc_dummy_1.stl
44.0 x 43.5 x 6.00
