Nidhood/PROJECT-CEFIRO/cefiro_description/meshes/chassis_upper_plate_1.stl

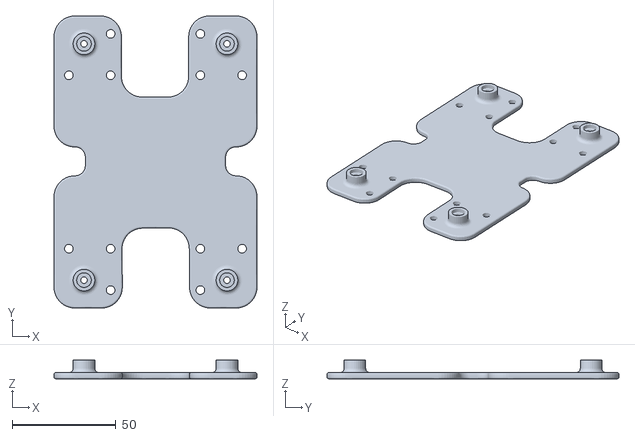
[picture p61: CAD file, 2026-10-26]
cefiro_description/meshes/chassis_upper_plate_1.stl
98.0 x 141.0 x 9.00
