Nidhood/PROJECT-CEFIRO/cefiro_description/meshes/gyro_ccv12_1.stl

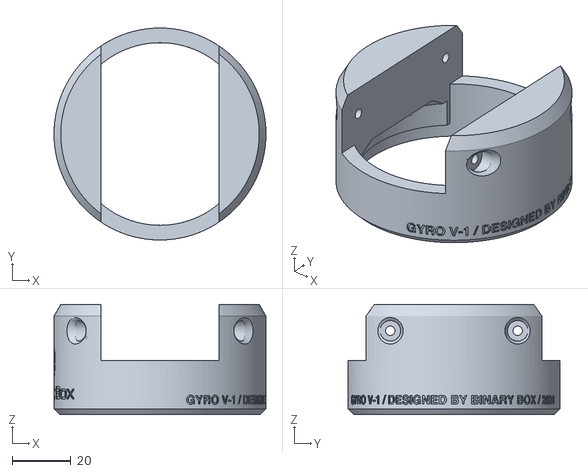
[picture p62: CAD file, 2026-10-26]
cefiro_description/meshes/gyro_ccv12_1.stl
72.0 x 72.0 x 37.5
