Nidhood/PROJECT-CEFIRO/cefiro_description/meshes/gyro_CON-P_360mm__3__1.stl

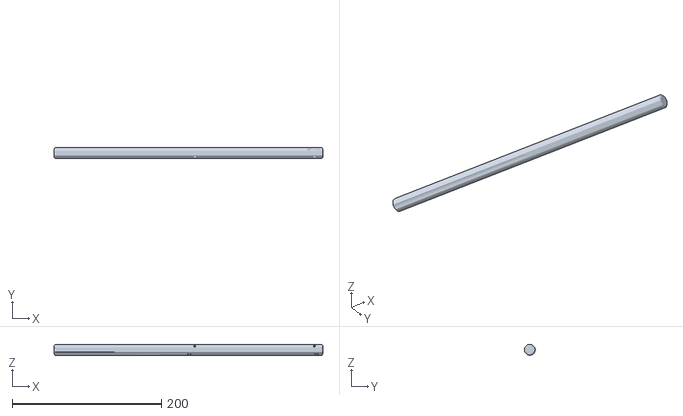
[picture p63: CAD file, 2026-10-26]
cefiro_description/meshes/gyro_CON-P_360mm__3__1.stl
360.1 x 14.2 x 14.2
