Nidhood/PROJECT-CEFIRO/cefiro_description/meshes/gyro_X1-SV__1__1.stl

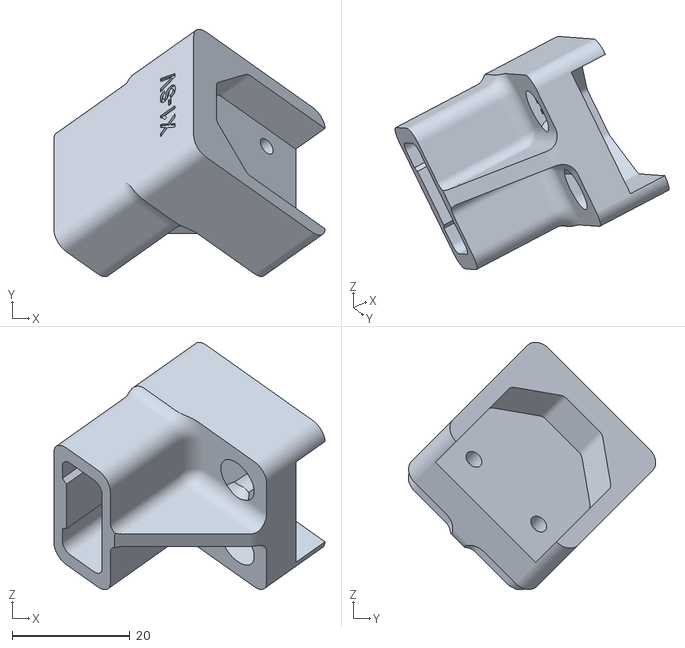
[picture p64: CAD file, 2026-10-26]
cefiro_description/meshes/gyro_X1-SV__1__1.stl
45.9 x 41.9 x 41.9
