Nidhood/PROJECT-CEFIRO/cefiro_description/meshes/gyro_X1__1__1.stl

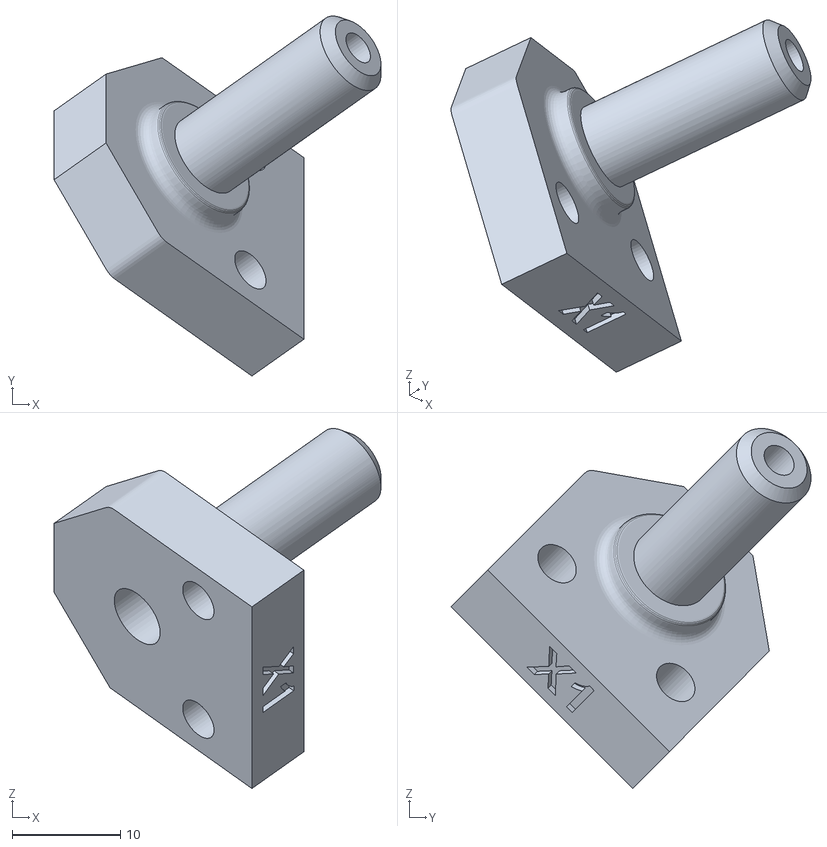
[picture p65: CAD file, 2026-10-26]
cefiro_description/meshes/gyro_X1__1__1.stl
30.2 x 33.3 x 33.3
