Nidhood/PROJECT-CEFIRO/cefiro_description/meshes/gyro_X1_1.stl

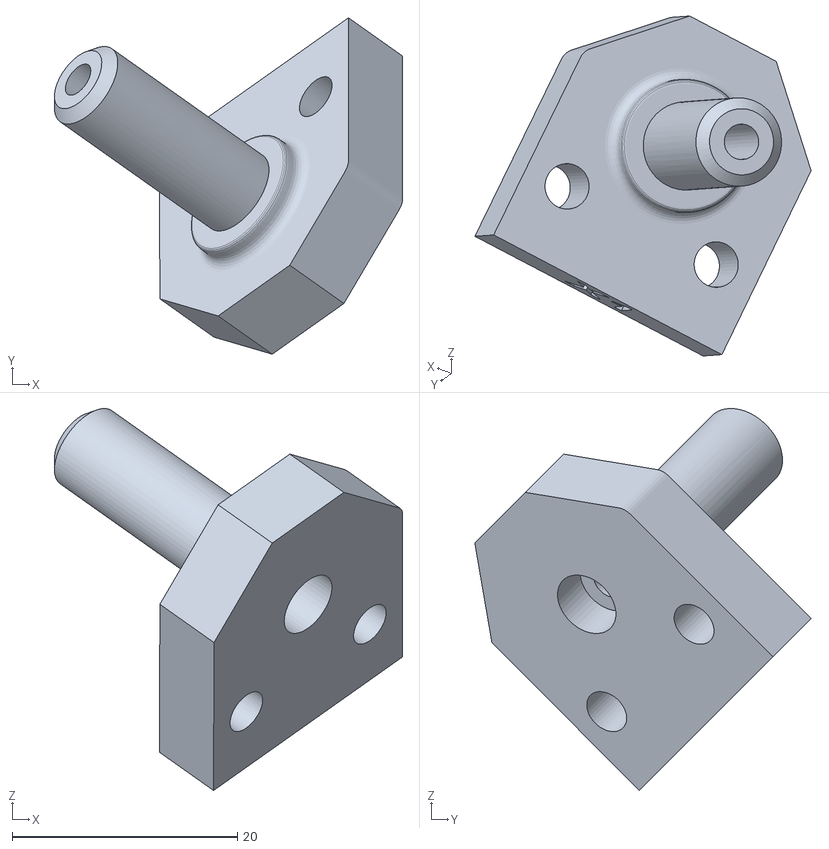
[picture p66: CAD file, 2026-10-26]
cefiro_description/meshes/gyro_X1_1.stl
30.9 x 29.9 x 33.9
