Nidhood/PROJECT-CEFIRO/cefiro_description/meshes/gyro_CON-BED-ADAPTER_6mm_1.stl

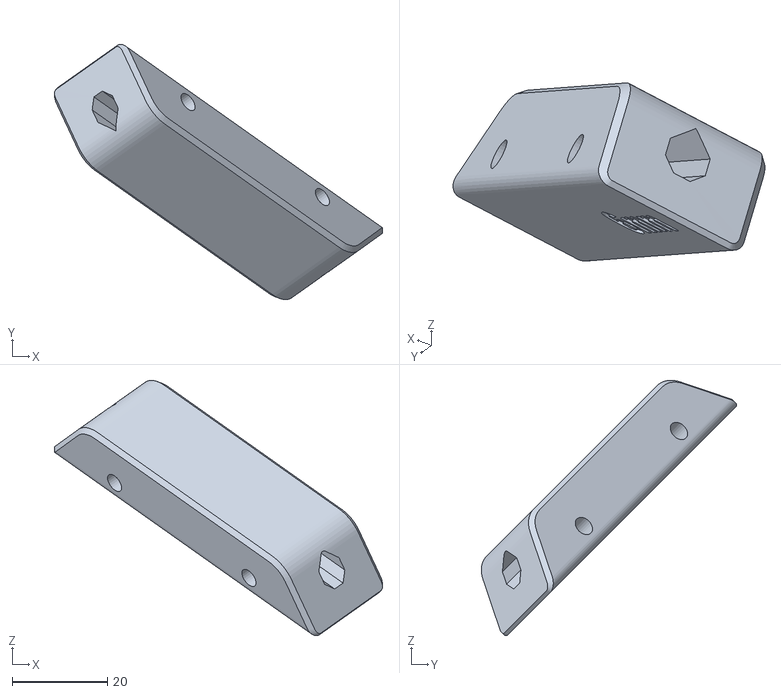
[picture p67: CAD file, 2026-10-26]
cefiro_description/meshes/gyro_CON-BED-ADAPTER_6mm_1.stl
69.0 x 53.7 x 53.7
