Nidhood/PROJECT-CEFIRO/(list of files, cad)

Other CAD files:
cefiro_description/meshes/frame/prop_cw.stl
cefiro_description/meshes/frame/propeller__2__1.stl
cefiro_description/meshes/gyro/gyro_snap-in-leg_1.stl
cefiro_description/meshes/motor_d3536_mount_1.stl
cefiro_description/meshes/frame/arm_coupling__1__1.stl
cefiro_description/meshes/motor_d3536_mount__2__1.stl
cefiro_description/meshes/frame/motor_d3536_1.stl
cefiro_description/meshes/arm-motor_coupling_1.stl
cefiro_description/meshes/frame/motor_d3536__1__1.stl
cefiro_description/meshes/gyro/gyro_R-BED_1.stl
cefiro_description/meshes/frame/propeller__1__1.stl
cefiro_description/meshes/frame/motor_d3536_mount__1__1.stl
cefiro_description/meshes/frame/damper_rubber__1__1.stl
cefiro_description/meshes/gyro/gyro_A2-LW__1__1.stl
cefiro_description/meshes/gyro_A2-LW__1__1.stl
cefiro_description/meshes/damper_rubber_1.stl
cefiro_description/meshes/gyro/gyro_CON-P_360mm__3__1.stl
cefiro_description/meshes/gyro_A1-LW__1__1.stl
cefiro_description/meshes/frame/damper_rubber_1.stl
cefiro_description/meshes/frame/motor_d3536_mount__3__1.stl
cefiro_description/meshes/gyro/gyro_CON-P_360mm_1.stl
cefiro_description/meshes/propeller_arm__3__1.stl
cefiro_description/meshes/gyro/gyro_X1_1.stl
cefiro_description/meshes/gyro_R-BED_1.stl
cefiro_description/meshes/frame/arm-motor_coupling__3__1.stl
cefiro_description/meshes/gyro/gyro_X1-SV__1__1.stl
cefiro_description/meshes/propeller__2__1.stl
cefiro_description/meshes/damper_rubber__3__1.stl
cefiro_description/meshes/frame/arm-motor_coupling_1.stl
cefiro_description/meshes/frame/arm_coupling_1.stl
cefiro_description/meshes/motor_d3536__2__1.stl
cefiro_description/meshes/arm-motor_coupling__3__1.stl
cefiro_description/meshes/frame/damper_rubber__2__1.stl
cefiro_description/meshes/frame/arm-motor_coupling__1__1.stl
cefiro_description/meshes/gyro_snap-in-leg__2__1.stl
cefiro_description/meshes/arm_coupling__1__1.stl
cefiro_description/meshes/frame/motor_coupling__3__1.stl
cefiro_description/meshes/frame/motor_d3536__3__1.stl
cefiro_description/meshes/gyro/gyro_A1-LW_1.stl
cefiro_description/meshes/motor_d3536_mount__3__1.stl
cefiro_description/meshes/frame/damper_rubber__3__1.stl
cefiro_description/meshes/gyro/gyro_B2S_1.stl
cefiro_description/meshes/gyro/gyro_CON-Y_368mm_1.stl
cefiro_description/meshes/propeller_arm_1.stl
cefiro_description/meshes/arm_coupling_left_1.stl
cefiro_description/meshes/frame/propeller_arm_1.stl
cefiro_description/meshes/frame/motor_d3536_mount_1.stl
cefiro_description/meshes/gyro/gyro_CON-P_360mm__1__1.stl
cefiro_description/meshes/propeller_arm__2__1.stl
cefiro_description/meshes/frame/propeller_arm__3__1.stl
cefiro_description/meshes/motor_d3536_mount__1__1.stl
cefiro_description/meshes/frame/motor_coupling_1.stl
cefiro_description/meshes/propeller_1.stl
cefiro_description/meshes/frame/propeller_1.stl
cefiro_description/meshes/frame/chassis_lower_plate.stl
cefiro_description/meshes/propeller__1__1.stl
cefiro_description/meshes/frame/motor_d3536__2__1.stl
cefiro_description/meshes/motor_d3536__3__1.stl
cefiro_description/meshes/damper_rubber__1__1.stl
cefiro_description/meshes/frame/fmu_dummy_1.stl
cefiro_description/meshes/arm_coupling_left__1__1.stl
cefiro_description/meshes/frame/arm_coupling_left___1__1.stl
cefiro_description/meshes/motor_coupling__3__1.stl
cefiro_description/meshes/arm-motor_coupling__1__1.stl
cefiro_description/meshes/motor_d3536__1__1.stl
cefiro_description/meshes/damper_plate__1.stl
cefiro_description/meshes/motor_coupling__1__1.stl
cefiro_description/meshes/propeller__3__1.stl
cefiro_description/meshes/gyro_CON-P_360mm__1__1.stl
cefiro_description/meshes/gyro_CON-P_360mm_1.stl
cefiro_description/meshes/gyro_B2S_1.stl
cefiro_description/meshes/esc_dummy_1.stl
cefiro_description/meshes/gyro_CON-P_360mm__2__1.stl
cefiro_description/meshes/motor_coupling_1.stl
