Nidhood/PROJECT-CEFIRO/cefiro/data/LQR/cefiro_attitude_test_1.csv

ros_time_s | sequence | roll_deg | pitch_deg | yaw_deg | ref_roll_deg | ref_pitch_deg | ref_yaw_deg | error_roll_deg | error_pitch_deg | error_yaw_deg | p_deg_s | q_deg_s | r_deg_s | ax_m_s2 | ay_m_s2 | az_m_s2 | Bx_uT | By_uT | Bz_uT | pressure_hPa | relative_alt_m | orientation_valid | mag_valid | baro_valid | strategy | source
255.4800000 | 23157 | -178.8111685 | -1.5604135 | 87.4209318 | 0.0000000 | 0.0000000 | 0.0000000 | 178.8111685 | 1.5604135 | -87.4209318 | -0.0265706 | 0.1359884 | 0.0187005 | 0.2525665 | -0.2130261 | -9.8016490 | -126929.4956139 | -245225.3687181 | 161720.4795979 | 1013.0859375 | -0.0585481 | 1 | 1 | 1 | OPEN LOOP | AUTOMATIC
255.4900000 | 23158 | -178.8111685 | -1.5604135 | 87.4209318 | 0.0000000 | 0.0000000 | 0.0000000 | 178.8111685 | 1.5604135 | -87.4209318 | 0.0877745 | 0.0815652 | -0.0576701 | 0.2507746 | -0.2124727 | -9.7858302 | -126929.4956139 | -245225.3687181 | 161720.4795979 | 1013.0817188 | -0.0234193 | 1 | 1 | 1 | OPEN LOOP | AUTOMATIC
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
