Nidhood/PROJECT-CEFIRO/cefiro/CHANGELOG.md

# PROJECT: CEFIRO

## 5 - 09 - 2026: Created a new file of change updates.
