Nidhood/PROJECT-CEFIRO/cefiro_description/urdf/gyro.xacro

<?xml version="1.0" ?>
<robot name="gyro" xmlns:xacro="http://www.ros.org/wiki/xacro">

  <link name="base_link">
    <inertial>
      <origin xyz="0.0011571731303746855 -0.014949350635758592 0.02164931364982968" rpy="0 0 0"/>
      <mass value="0.2961227403148616"/>
      <inertia ixx="0.000767" iyy="0.00055" izz="0.001242" ixy="0.0" iyz="-0.0" ixz="-0.0"/>
    </inertial>
    <visual>
      <origin xyz="0 0 0" rpy="0 0 0"/>
      <geometry>
        <mesh filename="package://cefiro_description/meshes/gyro/base_link.stl" scale="0.001 0.001 0.001"/>
      </geometry>
      <material name="silver"/>
    </visual>
    <collision>
      <origin xyz="0 0 0" rpy="0 0 0"/>
      <geometry>
        <mesh filename="package://cefiro_description/meshes/gyro/base_link.stl" scale="0.001 0.001 0.001"/>
      </geometry>
    </collision>
  </link>

  <link name="gyro_snap-in-leg_1">
    <inertial>
      <origin xyz="0.062963 0.098467 -0.017273" rpy="0 0 0"/>
      <mass value="0.0"/>
      <inertia ixx="0.0" iyy="0.0" izz="0.0" ixy="0.0" iyz="0.0" ixz="0.0"/>
    </inertial>
    <visual>
      <origin xyz="0.062963 0.098467 -0.017273" rpy="0 0 0"/>
      <geometry>
        <mesh filename="package://cefiro_description/meshes/gyro/gyro_snap-in-leg_1.stl" scale="0.001 0.001 0.001"/>
      </geometry>
      <material name="silver"/>
    </visual>
    <collision>
      <origin xyz="0.062963 0.098467 -0.017273" rpy="0 0 0"/>
      <geometry>
        <mesh filename="package://cefiro_description/meshes/gyro/gyro_snap-in-leg_1.stl" scale="0.001 0.001 0.001"/>
      </geometry>
    </collision>
  </link>

  <link name="gyro_snap-in-leg__1__1">
    <inertial>
      <origin xyz="0.074257 -0.057271 -0.017273" rpy="0 0 0"/>
      <mass value="0.0"/>
      <inertia ixx="0.0" iyy="0.0" izz="0.0" ixy="0.0" iyz="0.0" ixz="0.0"/>
    </inertial>
    <visual>
      <origin xyz="0.074257 -0.057271 -0.017273" rpy="0 0 0"/>
      <geometry>
        <mesh filename="package://cefiro_description/meshes/gyro/gyro_snap-in-leg__1__1.stl" scale="0.001 0.001 0.001"/>
      </geometry>
      <material name="silver"/>
    </visual>
    <collision>
      <origin xyz="0.074257 -0.057271 -0.017273" rpy="0 0 0"/>
      <geometry>
        <mesh filename="package://cefiro_description/meshes/gyro/gyro_snap-in-leg__1__1.stl" scale="0.001 0.001 0.001"/>
      </geometry>
    </collision>
  </link>

  <link name="gyro_snap-in-leg__2__1">
    <inertial>
      <origin xyz="-0.065269 -0.068569 -0.017273" rpy="0 0 0"/>
      <mass value="0.0"/>
      <inertia ixx="0.0" iyy="0.0" izz="0.0" ixy="0.0" iyz="0.0" ixz="0.0"/>
    </inertial>
    <visual>
      <origin xyz="-0.065269 -0.068569 -0.017273" rpy="0 0 0"/>
      <geometry>
        <mesh filename="package://cefiro_description/meshes/gyro/gyro_snap-in-leg__2__1.stl" scale="0.001 0.001 0.001"/>
      </geometry>
      <material name="silver"/>
    </visual>
    <collision>
      <origin xyz="-0.065269 -0.068569 -0.017273" rpy="0 0 0"/>
      <geometry>
        <mesh filename="package://cefiro_description/meshes/gyro/gyro_snap-in-leg__2__1.stl" scale="0.001 0.001 0.001"/>
      </geometry>
    </collision>
  </link>

  <link name="gyro_snap-in-leg__3__1">
    <inertial>
      <origin xyz="-0.074544 0.089198 -0.016523" rpy="0 0 0"/>
      <mass value="0.0"/>
      <inertia ixx="0.0" iyy="0.0" izz="0.0" ixy="0.0" iyz="0.0" ixz="0.0"/>
    </inertial>
    <visual>
      <origin xyz="-0.074544 0.089198 -0.016523" rpy="0 0 0"/>
      <geometry>
        <mesh filename="package://cefiro_description/meshes/gyro/gyro_snap-in-leg__3__1.stl" scale="0.001 0.001 0.001"/>
      </geometry>
      <material name="silver"/>
    </visual>
    <collision>
      <origin xyz="-0.074544 0.089198 -0.016523" rpy="0 0 0"/>
      <geometry>
        <mesh filename="package://cefiro_description/meshes/gyro/gyro_snap-in-leg__3__1.stl" scale="0.001 0.001 0.001"/>
      </geometry>
    </collision>
  </link>

  <link name="gyro_base_CPv12_1">
    <inertial>
      <origin xyz="-0.001156 0.014951 -0.031773" rpy="0 0 0"/>
      <mass value="0.0"/>
      <inertia ixx="0.0" iyy="0.0" izz="0.0" ixy="0.0" iyz="0.0" ixz="0.0"/>
    </inertial>
    <visual>
      <origin xyz="-0.001156 0.014951 -0.031773" rpy="0 0 0"/>
      <geometry>
        <mesh filename="package://cefiro_description/meshes/gyro/gyro_base_CPv12_1.stl" scale="0.001 0.001 0.001"/>
      </geometry>
      <material name="silver"/>
    </visual>
    <collision>
      <origin xyz="-0.001156 0.014951 -0.031773" rpy="0 0 0"/>
      <geometry>
        <mesh filename="package://cefiro_description/meshes/gyro/gyro_base_CPv12_1.stl" scale="0.001 0.001 0.001"/>
      </geometry>
    </collision>
  </link>

  <link name="gyro_ccv12_1">
    <inertial>
      <origin xyz="-0.001156 0.014951 -0.041673" rpy="0 0 0"/>
      <mass value="0.0"/>
      <inertia ixx="0.0" iyy="0.0" izz="0.0" ixy="0.0" iyz="0.0" ixz="0.0"/>
    </inertial>
    <visual>
      <origin xyz="-0.001156 0.014951 -0.041673" rpy="0 0 0"/>
      <geometry>
        <mesh filename="package://cefiro_description/meshes/gyro/gyro_ccv12_1.stl" scale="0.001 0.001 0.001"/>
      </geometry>
      <material name="silver"/>
    </visual>
    <collision>
      <origin xyz="-0.001156 0.014951 -0.041673" rpy="0 0 0"/>
      <geometry>
        <mesh filename="package://cefiro_description/meshes/gyro/gyro_ccv12_1.stl" scale="0.001 0.001 0.001"/>
      </geometry>
    </collision>
  </link>

  <link name="gyro_B1P_1">
    <inertial>
      <origin xyz="-0.001156 0.014951 -0.059173" rpy="0 0 0"/>
      <mass value="0.0"/>
      <inertia ixx="0.0" iyy="0.0" izz="0.0" ixy="0.0" iyz="0.0" ixz="0.0"/>
    </inertial>
    <visual>
      <origin xyz="-0.001156 0.014951 -0.059173" rpy="0 0 0"/>
      <geometry>
        <mesh filename="package://cefiro_description/meshes/gyro/gyro_B1P_1.stl" scale="0.001 0.001 0.001"/>
      </geometry>
      <material name="silver"/>
    </visual>
    <collision>
      <origin xyz="-0.001156 0.014951 -0.059173" rpy="0 0 0"/>
      <geometry>
        <mesh filename="package://cefiro_description/meshes/gyro/gyro_B1P_1.stl" scale="0.001 0.001 0.001"/>
      </geometry>
    </collision>
  </link>

  <link name="gyro_Y-DBA_1">
    <inertial>
      <origin xyz="2.9059467922362865e-07 8.60399398841874e-06 0.0022329783234873724" rpy="0 0 0"/>
      <mass value="0.015293274790880064"/>
      <inertia ixx="6e-06" iyy="6e-06" izz="1.2e-05" ixy="0.0" iyz="-0.0" ixz="-0.0"/>
    </inertial>
    <visual>
      <origin xyz="-0.001156 0.014951 -0.078173" rpy="0 0 0"/>
      <geometry>
        <mesh filename="package://cefiro_description/meshes/gyro/gyro_Y-DBA_1.stl" scale="0.001 0.001 0.001"/>
      </geometry>
      <material name="silver"/>
    </visual>
    <collision>
      <origin xyz="-0.001156 0.014951 -0.078173" rpy="0 0 0"/>
      <geometry>
        <mesh filename="package://cefiro_description/meshes/gyro/gyro_Y-DBA_1.stl" scale="0.001 0.001 0.001"/>
      </geometry>
    </collision>
  </link>

  <link name="gyro_Y-LOCK_1">
    <inertial>
      <origin xyz="-4.1981919979804105e-07 -4.708780733560236e-07 -0.005295109629470551" rpy="0 0 0"/>
      <mass value="0.0041583623164599464"/>
      <inertia ixx="0.0" iyy="0.0" izz="0.0" ixy="-0.0" iyz="0.0" ixz="0.0"/>
    </inertial>
    <visual>
      <origin xyz="-0.001156 0.014951 -0.082473" rpy="0 0 0"/>
      <geometry>
        <mesh filename="package://cefiro_description/meshes/gyro/gyro_Y-LOCK_1.stl" scale="0.001 0.001 0.001"/>
      </geometry>
      <material name="silver"/>
    </visual>
    <collision>
      <origin xyz="-0.001156 0.014951 -0.082473" rpy="0 0 0"/>
      <geometry>
        <mesh filename="package://cefiro_description/meshes/gyro/gyro_Y-LOCK_1.stl" scale="0.001 0.001 0.001"/>
      </geometry>
    </collision>
  </link>

  <link name="gyro_CON-Y_368mm_1">
    <inertial>
      <origin xyz="0.00046014841241998647 0.1308280219229364 0.13105552856890101" rpy="0 0 0"/>
      <mass value="0.07094391733872507"/>
      <inertia ixx="0.000807" iyy="0.000404" izz="0.000405" ixy="-1e-06" iyz="-0.000403" ixz="-1e-06"/>
    </inertial>
    <visual>
      <origin xyz="-0.001481 -0.125801 -0.086526" rpy="0 0 0"/>
      <geometry>
        <mesh filename="package://cefiro_description/meshes/gyro/gyro_CON-Y_368mm_1.stl" scale="0.001 0.001 0.001"/>
      </geometry>
      <material name="silver"/>
    </visual>
    <collision>
      <origin xyz="-0.001481 -0.125801 -0.086526" rpy="0 0 0"/>
      <geometry>
        <mesh filename="package://cefiro_description/meshes/gyro/gyro_CON-Y_368mm_1.stl" scale="0.001 0.001 0.001"/>
      </geometry>
    </collision>
  </link>

  <link name="gyro_CON-Y_368mm__1__1">
    <inertial>
      <origin xyz="-0.0001451604414352285 -0.13105600467752276 0.1308281954375885" rpy="0 0 0"/>
      <mass value="0.07094391733872507"/>
      <inertia ixx="0.000807" iyy="0.000405" izz="0.000404" ixy="-1e-06" iyz="0.000403" ixz="1e-06"/>
    </inertial>
    <visual>
      <origin xyz="-0.00083 0.155704 -0.086526" rpy="0 0 0"/>
      <geometry>
        <mesh filename="package://cefiro_description/meshes/gyro/gyro_CON-Y_368mm__1__1.stl" scale="0.001 0.001 0.001"/>
      </geometry>
      <material name="silver"/>
    </visual>
    <collision>
      <origin xyz="-0.00083 0.155704 -0.086526" rpy="0 0 0"/>
      <geometry>
        <mesh filename="package://cefiro_description/meshes/gyro/gyro_CON-Y_368mm__1__1.stl" scale="0.001 0.001 0.001"/>
      </geometry>
    </collision>
  </link>

  <link name="gyro_B2S-R_1">
    <inertial>
      <origin xyz="-0.000225 0.417397 -0.348219" rpy="0 0 0"/>
      <mass value="0.0"/>
      <inertia ixx="0.0" iyy="0.0" izz="0.0" ixy="0.0" iyz="0.0" ixz="0.0"/>
    </inertial>
    <visual>
      <origin xyz="-0.000225 0.417397 -0.348219" rpy="0 0 0"/>
      <geometry>
        <mesh filename="package://cefiro_description/meshes/gyro/gyro_B2S-R_1.stl" scale="0.001 0.001 0.001"/>
      </geometry>
      <material name="silver"/>
    </visual>
    <collision>
      <origin xyz="-0.000225 0.417397 -0.348219" rpy="0 0 0"/>
      <geometry>
        <mesh filename="package://cefiro_description/meshes/gyro/gyro_B2S-R_1.stl" scale="0.001 0.001 0.001"/>
      </geometry>
    </collision>
  </link>

  <link name="gyro_B2S_1">
    <inertial>
      <origin xyz="-0.002086 -0.387494 -0.348219" rpy="0 0 0"/>
      <mass value="0.0"/>
      <inertia ixx="0.0" iyy="0.0" izz="0.0" ixy="0.0" iyz="0.0" ixz="0.0"/>
    </inertial>
    <visual>
      <origin xyz="-0.002086 -0.387494 -0.348219" rpy="0 0 0"/>
      <geometry>
        <mesh filename="package://cefiro_description/meshes/gyro/gyro_B2S_1.stl" scale="0.001 0.001 0.001"/>
      </geometry>
      <material name="silver"/>
    </visual>
    <collision>
      <origin xyz="-0.002086 -0.387494 -0.348219" rpy="0 0 0"/>
      <geometry>
        <mesh filename="package://cefiro_description/meshes/gyro/gyro_B2S_1.stl" scale="0.001 0.001 0.001"/>
      </geometry>
    </collision>
  </link>

  <link name="gyro_A2-LW_1">
    <inertial>
      <origin xyz="-0.002089 -0.388847 -0.488972" rpy="0 0 0"/>
      <mass value="0.0"/>
      <inertia ixx="0.0" iyy="0.0" izz="0.0" ixy="0.0" iyz="0.0" ixz="0.0"/>
    </inertial>
    <visual>
      <origin xyz="-0.002089 -0.388847 -0.488972" rpy="0 0 0"/>
      <geometry>
        <mesh filename="package://cefiro_description/meshes/gyro/gyro_A2-LW_1.stl" scale="0.001 0.001 0.001"/>
      </geometry>
      <material name="silver"/>
    </visual>
    <collision>
      <origin xyz="-0.002089 -0.388847 -0.488972" rpy="0 0 0"/>
      <geometry>
        <mesh filename="package://cefiro_description/meshes/gyro/gyro_A2-LW_1.stl" scale="0.001 0.001 0.001"/>
      </geometry>
    </collision>
  </link>

  <link name="gyro_CON-P_360mm_1">
    <inertial>
      <origin xyz="0.12691013516768695 -0.1275268308090541 -0.00012374419014998805" rpy="0 0 0"/>
      <mass value="0.0670222866413884"/>
      <inertia ixx="0.000364" iyy="0.00036" izz="0.000722" ixy="0.00036" iyz="0.0" ixz="-0.0"/>
    </inertial>
    <visual>
      <origin xyz="-0.118665 -0.362637 -0.489072" rpy="0 0 0"/>
      <geometry>
        <mesh filename="package://cefiro_description/meshes/gyro/gyro_CON-P_360mm_1.stl" scale="0.001 0.001 0.001"/>
      </geometry>
      <material name="silver"/>
    </visual>
    <collision>
      <origin xyz="-0.118665 -0.362637 -0.489072" rpy="0 0 0"/>
      <geometry>
        <mesh filename="package://cefiro_description/meshes/gyro/gyro_CON-P_360mm_1.stl" scale="0.001 0.001 0.001"/>
      </geometry>
    </collision>
  </link>

  <link name="gyro_A1-LW_1">
    <inertial>
      <origin xyz="-0.372719 -0.107405 -0.48929" rpy="0 0 0"/>
      <mass value="0.0"/>
      <inertia ixx="0.0" iyy="0.0" izz="0.0" ixy="0.0" iyz="0.0" ixz="0.0"/>
    </inertial>
    <visual>
      <origin xyz="-0.372719 -0.107405 -0.48929" rpy="0 0 0"/>
      <geometry>
        <mesh filename="package://cefiro_description/meshes/gyro/gyro_A1-LW_1.stl" scale="0.001 0.001 0.001"/>
      </geometry>
      <material name="silver"/>
    </visual>
    <collision>
      <origin xyz="-0.372719 -0.107405 -0.48929" rpy="0 0 0"/>
      <geometry>
        <mesh filename="package://cefiro_description/meshes/gyro/gyro_A1-LW_1.stl" scale="0.001 0.001 0.001"/>
      </geometry>
    </collision>
  </link>

  <link name="gyro_CON-P_360mm__2__1">
    <inertial>
      <origin xyz="-0.1274984673027718 -0.12693779318759435 0.00012328076207634986" rpy="0 0 0"/>
      <mass value="0.0670222866413884"/>
      <inertia ixx="0.00036" iyy="0.000363" izz="0.000722" ixy="-0.00036" iyz="-0.0" ixz="-0.0"/>
    </inertial>
    <visual>
      <origin xyz="-0.372163 0.133197 -0.48929" rpy="0 0 0"/>
      <geometry>
        <mesh filename="package://cefiro_description/meshes/gyro/gyro_CON-P_360mm__2__1.stl" scale="0.001 0.001 0.001"/>
      </geometry>
      <material name="silver"/>
    </visual>
    <collision>
      <origin xyz="-0.372163 0.133197 -0.48929" rpy="0 0 0"/>
      <geometry>
        <mesh filename="package://cefiro_description/meshes/gyro/gyro_CON-P_360mm__2__1.stl" scale="0.001 0.001 0.001"/>
      </geometry>
    </collision>
  </link>

  <link name="gyro_CON-P_360mm__3__1">
    <inertial>
      <origin xyz="0.12770510657685546 0.12714431449154887 -0.00012332200891979062" rpy="0 0 0"/>
      <mass value="0.0670222866413884"/>
      <inertia ixx="0.00036" iyy="0.000364" izz="0.000722" ixy="-0.00036" iyz="-0.0" ixz="-0.0"/>
    </inertial>
    <visual>
      <origin xyz="0.369838 -0.109122 -0.488655" rpy="0 0 0"/>
      <geometry>
        <mesh filename="package://cefiro_description/meshes/gyro/gyro_CON-P_360mm__3__1.stl" scale="0.001 0.001 0.001"/>
      </geometry>
      <material name="silver"/>
    </visual>
    <collision>
      <origin xyz="0.369838 -0.109122 -0.488655" rpy="0 0 0"/>
      <geometry>
        <mesh filename="package://cefiro_description/meshes/gyro/gyro_CON-P_360mm__3__1.stl" scale="0.001 0.001 0.001"/>
      </geometry>
    </collision>
  </link>

  <link name="gyro_X1_1">
    <inertial>
      <origin xyz="-0.0024691111071020178 1.6711779799699622e-05 0.002241013718970064" rpy="0 0 0"/>
      <mass value="0.005899083895605196"/>
      <inertia ixx="0.0" iyy="1e-06" izz="0.0" ixy="0.0" iyz="0.0" ixz="0.0"/>
    </inertial>
    <visual>
      <origin xyz="-0.350047 0.012844 -0.48927" rpy="0 0 0"/>
      <geometry>
        <mesh filename="package://cefiro_description/meshes/gyro/gyro_X1_1.stl" scale="0.001 0.001 0.001"/>
      </geometry>
      <material name="silver"/>
    </visual>
    <collision>
      <origin xyz="-0.350047 0.012844 -0.48927" rpy="0 0 0"/>
      <geometry>
        <mesh filename="package://cefiro_description/meshes/gyro/gyro_X1_1.stl" scale="0.001 0.001 0.001"/>
      </geometry>
    </collision>
  </link>

  <link name="gyro_X1-SV_1">
    <inertial>
      <origin xyz="-0.341145 0.012825 -0.491324" rpy="0 0 0"/>
      <mass value="0.0"/>
      <inertia ixx="0.0" iyy="0.0" izz="0.0" ixy="0.0" iyz="0.0" ixz="0.0"/>
    </inertial>
    <visual>
      <origin xyz="-0.341145 0.012825 -0.491324" rpy="0 0 0"/>
      <geometry>
        <mesh filename="package://cefiro_description/meshes/gyro/gyro_X1-SV_1.stl" scale="0.001 0.001 0.001"/>
      </geometry>
      <material name="silver"/>
    </visual>
    <collision>
      <origin xyz="-0.341145 0.012825 -0.491324" rpy="0 0 0"/>
      <geometry>
        <mesh filename="package://cefiro_description/meshes/gyro/gyro_X1-SV_1.stl" scale="0.001 0.001 0.001"/>
      </geometry>
    </collision>
  </link>

  <link name="gyro_CF_Rod_1">
    <inertial>
      <origin xyz="-0.3259988090669113 0.0007535309577930676 -0.0002781729336499006" rpy="0 0 0"/>
      <mass value="0.0213844442018673"/>
      <inertia ixx="0.0" iyy="0.000758" izz="0.000758" ixy="2e-06" iyz="0.0" ixz="-1e-06"/>
    </inertial>
    <visual>
      <origin xyz="-0.326155 0.012803 -0.479312" rpy="0 0 0"/>
      <geometry>
        <mesh filename="package://cefiro_description/meshes/gyro/gyro_CF_Rod_1.stl" scale="0.001 0.001 0.001"/>
      </geometry>
      <material name="silver"/>
    </visual>
    <collision>
      <origin xyz="-0.326155 0.012803 -0.479312" rpy="0 0 0"/>
      <geometry>
        <mesh filename="package://cefiro_description/meshes/gyro/gyro_CF_Rod_1.stl" scale="0.001 0.001 0.001"/>
      </geometry>
    </collision>
  </link>

  <link name="gyro_R-BED_1">
    <inertial>
      <origin xyz="-0.10352420055043005 0.0002330410959185663 0.0008161723715476854" rpy="0 0 0"/>
      <mass value="0.019226377494430135"/>
      <inertia ixx="1e-06" iyy="7.5e-05" izz="7.6e-05" ixy="0.0" iyz="0.0" ixz="-0.0"/>
    </inertial>
    <visual>
      <origin xyz="-0.328655 0.012809 -0.479564" rpy="0 0 0"/>
      <geometry>
        <mesh filename="package://cefiro_description/meshes/gyro/gyro_R-BED_1.stl" scale="0.001 0.001 0.001"/>
      </geometry>
      <material name="silver"/>
    </visual>
    <collision>
      <origin xyz="-0.328655 0.012809 -0.479564" rpy="0 0 0"/>
      <geometry>
        <mesh filename="package://cefiro_description/meshes/gyro/gyro_R-BED_1.stl" scale="0.001 0.001 0.001"/>
      </geometry>
    </collision>
  </link>

  <link name="gyro_R-BED__1__1">
    <inertial>
      <origin xyz="0.10102261074029514 -0.00022696844238441483 0.0012408438402203292" rpy="0 0 0"/>
      <mass value="0.019226377494430135"/>
      <inertia ixx="1e-06" iyy="7.5e-05" izz="7.6e-05" ixy="0.0" iyz="-0.0" ixz="-0.0"/>
    </inertial>
    <visual>
      <origin xyz="0.325843 0.011296 -0.478755" rpy="0 0 0"/>
      <geometry>
        <mesh filename="package://cefiro_description/meshes/gyro/gyro_R-BED__1__1.stl" scale="0.001 0.001 0.001"/>
      </geometry>
      <material name="silver"/>
    </visual>
    <collision>
      <origin xyz="0.325843 0.011296 -0.478755" rpy="0 0 0"/>
      <geometry>
        <mesh filename="package://cefiro_description/meshes/gyro/gyro_R-BED__1__1.stl" scale="0.001 0.001 0.001"/>
      </geometry>
    </collision>
  </link>

  <link name="gyro_X1__1__1">
    <inertial>
      <origin xyz="0.002464952734687831 -1.709858660562877e-05 0.002245225309986887" rpy="0 0 0"/>
      <mass value="0.005899083895605196"/>
      <inertia ixx="0.0" iyy="1e-06" izz="0.0" ixy="0.0" iyz="-0.0" ixz="-0.0"/>
    </inertial>
    <visual>
      <origin xyz="0.347722 0.01123 -0.488674" rpy="0 0 0"/>
      <geometry>
        <mesh filename="package://cefiro_description/meshes/gyro/gyro_X1__1__1.stl" scale="0.001 0.001 0.001"/>
      </geometry>
      <material name="silver"/>
    </visual>
    <collision>
      <origin xyz="0.347722 0.01123 -0.488674" rpy="0 0 0"/>
      <geometry>
        <mesh filename="package://cefiro_description/meshes/gyro/gyro_X1__1__1.stl" scale="0.001 0.001 0.001"/>
      </geometry>
    </collision>
  </link>

  <link name="gyro_X1-SV__1__1">
    <inertial>
      <origin xyz="0.338824 0.011249 -0.490743" rpy="0 0 0"/>
      <mass value="0.0"/>
      <inertia ixx="0.0" iyy="0.0" izz="0.0" ixy="0.0" iyz="0.0" ixz="0.0"/>
    </inertial>
    <visual>
      <origin xyz="0.338824 0.011249 -0.490743" rpy="0 0 0"/>
      <geometry>
        <mesh filename="package://cefiro_description/meshes/gyro/gyro_X1-SV__1__1.stl" scale="0.001 0.001 0.001"/>
      </geometry>
      <material name="silver"/>
    </visual>
    <collision>
      <origin xyz="0.338824 0.011249 -0.490743" rpy="0 0 0"/>
      <geometry>
        <mesh filename="package://cefiro_description/meshes/gyro/gyro_X1-SV__1__1.stl" scale="0.001 0.001 0.001"/>
      </geometry>
    </collision>
  </link>

  <link name="gyro_drone_baseB_1">
    <inertial>
      <origin xyz="-0.0001544208838804989 0.0005767916477225649 0.001312845423951825" rpy="0 0 0"/>
      <mass value="0.7026029896442744"/>
      <inertia ixx="12.720417" iyy="20.565111" izz="33.123626" ixy="0.056906" iyz="-0.001329" ixz="-0.016107"/>
    </inertial>
    <visual>
      <origin xyz="-0.019065 0.012093 -0.488" rpy="0 0 0"/>
      <geometry>
        <mesh filename="package://cefiro_description/meshes/gyro/gyro_drone_baseB_1.stl" scale="0.001 0.001 0.001"/>
      </geometry>
      <material name="silver"/>
    </visual>
    <collision>
      <origin xyz="-0.019065 0.012093 -0.488" rpy="0 0 0"/>
      <geometry>
        <mesh filename="package://cefiro_description/meshes/gyro/gyro_drone_baseB_1.stl" scale="0.001 0.001 0.001"/>
      </geometry>
    </collision>
  </link>

  <link name="gyro_A2-LW__1__1">
    <inertial>
      <origin xyz="-0.116931 0.38725 -0.489072" rpy="0 0 0"/>
      <mass value="0.0"/>
      <inertia ixx="0.0" iyy="0.0" izz="0.0" ixy="0.0" iyz="0.0" ixz="0.0"/>
    </inertial>
    <visual>
      <origin xyz="-0.116931 0.38725 -0.489072" rpy="0 0 0"/>
      <geometry>
        <mesh filename="package://cefiro_description/meshes/gyro/gyro_A2-LW__1__1.stl" scale="0.001 0.001 0.001"/>
      </geometry>
      <material name="silver"/>
    </visual>
    <collision>
      <origin xyz="-0.116931 0.38725 -0.489072" rpy="0 0 0"/>
      <geometry>
        <mesh filename="package://cefiro_description/meshes/gyro/gyro_A2-LW__1__1.stl" scale="0.001 0.001 0.001"/>
      </geometry>
    </collision>
  </link>

  <link name="gyro_CON-P_360mm__1__1">
    <inertial>
      <origin xyz="-0.12714358122604158 0.12770493355062845 -0.00034151346905458846" rpy="0 0 0"/>
      <mass value="0.0670222866413884"/>
      <inertia ixx="0.000364" iyy="0.00036" izz="0.000722" ixy="0.00036" iyz="0.0" ixz="-0.0"/>
    </inertial>
    <visual>
      <origin xyz="0.116341 0.386711 -0.488873" rpy="0 0 0"/>
      <geometry>
        <mesh filename="package://cefiro_description/meshes/gyro/gyro_CON-P_360mm__1__1.stl" scale="0.001 0.001 0.001"/>
      </geometry>
      <material name="silver"/>
    </visual>
    <collision>
      <origin xyz="0.116341 0.386711 -0.488873" rpy="0 0 0"/>
      <geometry>
        <mesh filename="package://cefiro_description/meshes/gyro/gyro_CON-P_360mm__1__1.stl" scale="0.001 0.001 0.001"/>
      </geometry>
    </collision>
  </link>

  <link name="gyro_A1-LW__1__1">
    <inertial>
      <origin xyz="0.370394 0.13148 -0.488655" rpy="0 0 0"/>
      <mass value="0.0"/>
      <inertia ixx="0.0" iyy="0.0" izz="0.0" ixy="0.0" iyz="0.0" ixz="0.0"/>
    </inertial>
    <visual>
      <origin xyz="0.370394 0.13148 -0.488655" rpy="0 0 0"/>
      <geometry>
        <mesh filename="package://cefiro_description/meshes/gyro/gyro_A1-LW__1__1.stl" scale="0.001 0.001 0.001"/>
      </geometry>
      <material name="silver"/>
    </visual>
    <collision>
      <origin xyz="0.370394 0.13148 -0.488655" rpy="0 0 0"/>
      <geometry>
        <mesh filename="package://cefiro_description/meshes/gyro/gyro_A1-LW__1__1.stl" scale="0.001 0.001 0.001"/>
      </geometry>
    </collision>
  </link>

  <link name="gyro_CON-BED-ADAPTER_6mm_1">
    <inertial>
      <origin xyz="0.018951614987808292 -4.575464303644208e-05 -0.000987034675029197" rpy="0 0 0"/>
      <mass value="0.02290627435505764"/>
      <inertia ixx="1e-06" iyy="1e-05" izz="1e-05" ixy="0.0" iyz="0.0" ixz="-0.0"/>
    </inertial>
    <visual>
      <origin xyz="-0.000154 0.012049 -0.482034" rpy="0 0 0"/>
      <geometry>
        <mesh filename="package://cefiro_description/meshes/gyro/gyro_CON-BED-ADAPTER_6mm_1.stl" scale="0.001 0.001 0.001"/>
      </geometry>
      <material name="silver"/>
    </visual>
    <collision>
      <origin xyz="-0.000154 0.012049 -0.482034" rpy="0 0 0"/>
      <geometry>
        <mesh filename="package://cefiro_description/meshes/gyro/gyro_CON-BED-ADAPTER_6mm_1.stl" scale="0.001 0.001 0.001"/>
      </geometry>
    </collision>
  </link>

  <joint name="gyro_rIgid_1" type="fixed">
    <origin xyz="-0.062963 -0.098467 0.017273" rpy="0 0 0"/>
    <parent link="base_link"/>
    <child link="gyro_snap-in-leg_1"/>
  </joint>

  <joint name="gyro_rIgid_2" type="fixed">
    <origin xyz="-0.074257 0.057271 0.017273" rpy="0 0 0"/>
    <parent link="base_link"/>
    <child link="gyro_snap-in-leg__1__1"/>
  </joint>

  <joint name="gyro_rIgid_3" type="fixed">
    <origin xyz="0.065269 0.068569 0.017273" rpy="0 0 0"/>
    <parent link="base_link"/>
    <child link="gyro_snap-in-leg__2__1"/>
  </joint>

  <joint name="gyro_rIgid_4" type="fixed">
    <origin xyz="0.074544 -0.089198 0.016523" rpy="0 0 0"/>
    <parent link="base_link"/>
    <child link="gyro_snap-in-leg__3__1"/>
  </joint>

  <joint name="gyro_rIgid_5" type="fixed">
    <origin xyz="0.001156 -0.014951 0.031773" rpy="0 0 0"/>
    <parent link="base_link"/>
    <child link="gyro_base_CPv12_1"/>
  </joint>

  <joint name="gyro_rIgid_6" type="fixed">
    <origin xyz="0.0 0.0 0.0099" rpy="0 0 0"/>
    <parent link="gyro_base_CPv12_1"/>
    <child link="gyro_ccv12_1"/>
  </joint>

  <joint name="yaw" type="continuous">
    <origin xyz="0.0 0.0 0.0274" rpy="0 0 0"/>
    <parent link="gyro_base_CPv12_1"/>
    <child link="gyro_B1P_1"/>
    <axis xyz="0.0 -0.0 -1.0"/>
  </joint>

  <joint name="gyro_rIgid_8" type="fixed">
    <origin xyz="0.0 0.0 0.019" rpy="0 0 0"/>
    <parent link="gyro_B1P_1"/>
    <child link="gyro_Y-DBA_1"/>
  </joint>

  <joint name="gyro_rIgid_9" type="fixed">
    <origin xyz="0.0 0.0 0.0043" rpy="0 0 0"/>
    <parent link="gyro_Y-DBA_1"/>
    <child link="gyro_Y-LOCK_1"/>
  </joint>

  <joint name="gyro_rIgid_10" type="fixed">
    <origin xyz="0.000325 0.140752 0.027353" rpy="0 0 0"/>
    <parent link="gyro_B1P_1"/>
    <child link="gyro_CON-Y_368mm_1"/>
  </joint>

  <joint name="gyro_rIgid_11" type="fixed">
    <origin xyz="-0.000326 -0.140753 0.027353" rpy="0 0 0"/>
    <parent link="gyro_B1P_1"/>
    <child link="gyro_CON-Y_368mm__1__1"/>
  </joint>

  <joint name="gyro_rIgid_48" type="fixed">
    <origin xyz="-0.000605 -0.261693 0.261693" rpy="0 0 0"/>
    <parent link="gyro_CON-Y_368mm__1__1"/>
    <child link="gyro_B2S-R_1"/>
  </joint>

  <joint name="gyro_rIgid_49" type="fixed">
    <origin xyz="0.000605 0.261693 0.261693" rpy="0 0 0"/>
    <parent link="gyro_CON-Y_368mm_1"/>
    <child link="gyro_B2S_1"/>
  </joint>

  <joint name="pitch" type="continuous">
    <origin xyz="3e-06 0.001353 0.140753" rpy="0 0 0"/>
    <parent link="gyro_B2S_1"/>
    <child link="gyro_A2-LW_1"/>
    <axis xyz="-0.002312 -0.999997 -0.0"/>
  </joint>

  <joint name="gyro_rIgid_52" type="fixed">
    <origin xyz="0.116576 -0.02621 0.0001" rpy="0 0 0"/>
    <parent link="gyro_A2-LW_1"/>
    <child link="gyro_CON-P_360mm_1"/>
  </joint>

  <joint name="gyro_rIgid_53" type="fixed">
    <origin xyz="0.254054 -0.255232 0.000218" rpy="0 0 0"/>
    <parent link="gyro_CON-P_360mm_1"/>
    <child link="gyro_A1-LW_1"/>
  </joint>

  <joint name="gyro_rIgid_54" type="fixed">
    <origin xyz="-0.000556 -0.240602 0.0" rpy="0 0 0"/>
    <parent link="gyro_A1-LW_1"/>
    <child link="gyro_CON-P_360mm__2__1"/>
  </joint>

  <joint name="gyro_rIgid_57" type="fixed">
    <origin xyz="0.000556 0.240602 0.0" rpy="0 0 0"/>
    <parent link="gyro_A1-LW__1__1"/>
    <child link="gyro_CON-P_360mm__3__1"/>
  </joint>

  <joint name="roll" type="continuous">
    <origin xyz="-0.022672 -0.120249 -2e-05" rpy="0 0 0"/>
    <parent link="gyro_A1-LW_1"/>
    <child link="gyro_X1_1"/>
    <axis xyz="-0.999997 0.002312 -0.000854"/>
  </joint>

  <joint name="gyro_rIgid_62" type="fixed">
    <origin xyz="-0.008902 1.9e-05 0.002054" rpy="0 0 0"/>
    <parent link="gyro_X1_1"/>
    <child link="gyro_X1-SV_1"/>
  </joint>

  <joint name="gyro_rIgid_63" type="fixed">
    <origin xyz="-0.0025 6e-06 -0.000252" rpy="0 0 0"/>
    <parent link="gyro_R-BED_1"/>
    <child link="gyro_CF_Rod_1"/>
  </joint>

  <joint name="gyro_rIgid_64" type="fixed">
    <origin xyz="-0.01249 1.6e-05 -0.01176" rpy="0 0 0"/>
    <parent link="gyro_X1-SV_1"/>
    <child link="gyro_R-BED_1"/>
  </joint>

  <joint name="gyro_rIgid_65" type="fixed">
    <origin xyz="-0.651998 0.001507 -0.000557" rpy="0 0 0"/>
    <parent link="gyro_CF_Rod_1"/>
    <child link="gyro_R-BED__1__1"/>
  </joint>

  <joint name="fixed_roll" type="fixed">
    <origin xyz="0.022672 0.12025 1.9e-05" rpy="0 0 0"/>
    <parent link="gyro_A1-LW__1__1"/>
    <child link="gyro_X1__1__1"/>
    <axis xyz="0.999997 -0.002312 0.000854"/>
  </joint>

  <joint name="gyro_rIgid_67" type="fixed">
    <origin xyz="0.008898 -1.9e-05 0.002069" rpy="0 0 0"/>
    <parent link="gyro_X1__1__1"/>
    <child link="gyro_X1-SV__1__1"/>
  </joint>

  <joint name="gyro_rIgid_69" type="fixed">
    <origin xyz="0.018911 -4.4e-05 0.005966" rpy="0 0 0"/>
    <parent link="gyro_CON-BED-ADAPTER_6mm_1"/>
    <child link="gyro_drone_baseB_1"/>
  </joint>

  <joint name="gyro_rIgid_70" type="fixed">
    <origin xyz="-0.255232 -0.254053 -0.000218" rpy="0 0 0"/>
    <parent link="gyro_CON-P_360mm__2__1"/>
    <child link="gyro_A2-LW__1__1"/>
  </joint>

  <joint name="gyro_rIgid_71" type="fixed">
    <origin xyz="-0.233272 0.000539 -0.000199" rpy="0 0 0"/>
    <parent link="gyro_A2-LW__1__1"/>
    <child link="gyro_CON-P_360mm__1__1"/>
  </joint>

  <joint name="gyro_rIgid_72" type="fixed">
    <origin xyz="-0.254053 0.255231 -0.000218" rpy="0 0 0"/>
    <parent link="gyro_CON-P_360mm__1__1"/>
    <child link="gyro_A1-LW__1__1"/>
  </joint>

  <joint name="gyro_rIgid_73" type="fixed">
    <origin xyz="-0.326001 0.000754 0.002722" rpy="0 0 0"/>
    <parent link="gyro_CF_Rod_1"/>
    <child link="gyro_CON-BED-ADAPTER_6mm_1"/>
  </joint>

</robot>
