Nidhood/PROJECT-CEFIRO/cefiro/data/LQR/cefiro_run_20261106_155118_051_metadata.yaml

cefiro_experiment:
  created_at: "2026-11-06T15:51:18"
  data_file: "/home/nidhood/cefiro_ws/src/cefiro/data/LQR/cefiro_run_20261106_155118_051.csv"
  notes: ""
  strategy: "SWING-UP + LQR (SIM)"
  source: "AUTOMATIC"
  capture_mode: "Continuous"
  start_delay_s: 0
  save_interval_ms: 0
  duration_s: 10
  requested_periods: 10
  waveform_frequency_hz: 0.25
  peak_axis: "ROLL"
  peak_threshold_deg: 10
  peak_target: 5
  peak_min_separation_s: 0.2
  controller_acknowledgement: available
  time_unit: "s"
  saved_groups:
    attitude: true
    reference: true
    error: true
    rates: true
    acceleration: true
    magnetic_field: true
    barometer: true
    validity_flags: true
    strategy_source: true
