Nidhood/PROJECT-CEFIRO/(commit log)

2026-08-31 🎉 Initial Commit: New update !!! Structured folder organization and added firsts sensors folders.
2026-09-05 🚀 RELEASE: New sensor added !!! bmp581 - insane.
    [Malla.046.stl, Part__Feature131.stl, base_link.stl, bmp581.urdf.xacro, bmp581_gz.xacro, bmp581_test_ball.xacro, desk.sdf, lamp.sdf]
2026-09-05 📖 DOC: First entry of CHANGELOG
2026-09-05 💥 NEW: IMU and magnetometer sensors created
    [imu_icm42670p.urdf.xacro, imu_icm42670p_gz.urdf.xacro, magnetometer_mmc5983ma.urdf.xacro, magnetometer_mmc5983ma_gz.urdf.xacro]
2026-09-05 ✨ New Feature: IMU and magnetometer topics added to the bridge
2026-09-12 🐛 FIX: Typos corrected
    [bmp581.urdf.xacro, magnetometer_mmc5983ma.urdf.xacro]
2026-09-12 💥 NEW: Mesh files for IMU and magnetometer sensors added
    [base_link.stl]
2026-09-12 👌 IMPROVE: Errors fixed and meshes implemented
    [imu_icm42670p.urdf.xacro, magnetometer_mmc5983ma.urdf.xacro]
2026-09-12 👌 IMPROVE: test_ball is now available for all sensors
    [test_ball.xacro]
2026-09-12 💥 NEW: RViz config file added for sensors visualization
2026-09-12 🐛 FIX: Typo corrected in magnetometer sensor type
    [magnetometer_mmc5983ma_gz.urdf.xacro]
2026-09-12 ✨ New Feature: Magnetometer plugin added
    [main_world.sdf]
2026-09-12 📦 Configuration: Magnetometer and IMU masses update
2026-10-26 🎉 Initial Commit: Initial commit for cefiro_description package
2026-10-28 ✨ New Feature: RViz2 visualization available for CEFIRO's frame, gyro and their assembly
2026-10-31 👌 IMPROVE: Improved visualization of gyro
2026-11-01 👌 IMPROVE: URDF files renamed in order to meet naming convention
2026-11-02 🐛 FIX: Fixed cefiro_description launch codes, enhance modularity and better lecture.
2026-11-02 🐛 FIX:
    - cefiro_description: Organized and optimized urdf publisher.
    - cefiro_gz: Fasted spawn and better performance.
    💥 NEW:
    - cefiro: Added new public content to appreciate the project results.
    - cefiro_gui: Interactive HMI panel to motorize and operate cefiro.
2026-11-02 💥 NEW: Added cefiro_actuators, which simulates the motors dynamics into gazebo
2026-11-02 🐛 FIX: Fixed trash files & HMI UI quality.
2026-11-02 👌 IMPROVE: Deleted trash files.
2026-11-03 🎉 Initial Commit: Initial commit for cefiro_control package
2026-11-03 👌 IMPROVE: Name changed
2026-11-03 🎉 Initial Commit: Initial commit for cefiro_matlab, a folder to save MATLAB files related to the project
2026-11-04 👌 IMPROVE: Update hardware_interface package.
2026-11-04 👌 IMPROVE: Updated hardware_interface.
2026-11-04 👌 IMPROVE: Update hardware_interface.
2026-11-04 👌 IMPROVE: Update cefiro_control
2026-11-04 👌 IMPROVE: Control included in launch file
2026-11-04 👌 IMPROVE: Deleted max RPM limitation.
2026-11-06 🚀 RELEASE: Controller fixed and working !!!
2026-11-06 👌 IMPROVE: Better name.
2026-11-06 💥 NEW: Updated readme.
2026-11-09 ⚡ General Update: New update.
2026-11-10 🚀 Deploy: Updates and fixes.
2026-11-11 👌 IMPROVE: Better shadings.
