Nidhood/PROJECT-CEFIRO/(notices)

Notices in the files:
README.md:
License: BSD--2--Clause
